MartinPuli/feel/web/README.md

# FEEL website

Static site with no dependencies. `/replay` plays back a session:
- **Left:** the camera recording. This is the iPhone's video for phone recordings, or a rendered view for simulated scenes.
- **Right, stacked:** the 6 × 4 physical pin grid the firmware commanded, above the LiDAR depth frame that drove it. Wire slot 0 is reserved.
- **Below:** a timeline of every column against the labels.

Choose any session, simulated or recorded, from the menu. `?session=<name>` links straight to one. Under the recording, a **top view** plots the LiDAR points from above with the six physical column sectors (simulated sessions also outline the true objects). At each labelled moment, the pin grid shows expected pins and pink-rings any mismatch; the table names the exact physical column, wire slot, expected band, and actual band. Grid-walk trial marks (bump, unsure, arrived) appear on the timeline. **Export video** records a 1920 × 1080 MP4 of the replay for demo videos. See [docs/GRID-WALK.md](../docs/GRID-WALK.md) for live field tests.

```sh
python3 simulation/run.py     # scores every scenario and writes the replay data to simulation/out/web
python3 simulation/unit_tests.py # runs Swift tests and writes their summary for /replay
python3 simulation/pin_diagnostics.py # checks each active pin's app packet and firmware command path
cd web && npm run dev         # http://127.0.0.1:3000/replay
npm test                      # server, six-column replay, report rendering and public-build tests
```

The dev server binds 127.0.0.1 only. It serves `public/` and maps `/replay/data/*` to `simulation/out/web/`, with byte ranges so video can seek. Space plays and pauses; the arrow keys step one 10 Hz tick.

## Phone sessions

In Lantern, turn on **Record depth**. **Include camera video** is a separate explicit choice. The phone writes three files to Files › On My iPhone › FEEL › Recordings:
- `feel-<time>.feelrec`
- `feel-<time>.mp4` (960 × 720 H.264, 15 fps, no audio)
- `feel-<time>.video.json`, which ties video time 0 to the ARKit clock

Trials started in **Grid walk** also write `feel-<time>.events.json`. Copy them all into `simulation/recordings/` and run `simulation/run.py`, or do both with `scripts/pull_recordings.sh` while the phone is connected. New walks appear automatically as `UNLABELLED` sessions; add a scenario in `simulation/scenarios/` to label one.

## Before and after a code change

The page can show two runs of the same recording side by side:

```sh
python3 simulation/run.py --snapshot before    # save this run's pins as "before"
# edit the encoder, column geometry, firmware controller…
python3 simulation/run.py                      # rerun; the run before this one is also kept as "previous"
```

Pick `before` (or `previous`) in the **compare** menu under the scrubber. The pin grid splits into **now** and the snapshot, with changed pins ringed; each timeline row shows now on top and the snapshot below with a mark where they differ; the metrics add how many ticks changed and label agreement snapshot → now. The **◀ diff / diff ▶** buttons (or `[` and `]`) step between differences. `?compare=<label>` links to a comparison. Snapshots live in `simulation/out/web/snapshots/` and are not deployed.

## Deploying

`npm run build` writes `dist/`: the site plus every **simulated** session. **Phone recordings are left out** unless their scenario sets `"publish": true`, because the camera video shows real places and people. The build prints how many it withheld.

The replay data is generated on this machine (Vercel can't run the Swift and C++ replay), so deploy the built folder from here rather than from Git:

```sh
cd web && npm run build && vercel deploy        # preview; add --prod for production
```

`vercel.json` serves `dist/` with no install or build step, with clean URLs and short caching on replay data. Set the Vercel project's root directory to `web`. This deploy path has not been run yet. Check the first preview before promoting it. If the site gets a different home later, `dist/` is plain static files and can be hosted anywhere.

## Branch integration

The six-column display, labelled pin checks and software-report panels come from
`replay-pin-diagnostics` (`6d41c62`). Public builds include only selected report
fields, omit raw build errors and retain the physical-validation limitation.
Reports describe the timestamped run shown; they do not certify the current checkout.

The snapshot comparison from `ethan/cad` (`48774f0`) is not included. It still
uses seven physical columns and can install a stale comparison after a session
change. A future port needs six-column alignment, request cancellation, matching
input identities and tests before it can support reliable comparisons.
