MartinPuli/feel/docs/RELEASE-STATUS.md

## October 18 UTC — current production readiness

**Not ready for unrestricted production.** Latest source, cloud checks and remaining device/configuration gates are recorded in [PRODUCTION-READINESS.md](PRODUCTION-READINESS.md). That report supersedes the historical counts and branch/deployment statements below.

The unsafe 150 ms restoration of old pin bands after a neutral packet has been removed. Only a fresh valid command can raise them again. The latest user-selected GPIO25 calibration is now merged; wiring is unchanged and this firmware has not been flashed. Shared context reads now have a verified-user server boundary, but remain opt-in and inactive until their server deployment is verified. Chalk and existing voice remain usable without that optional connection. See [ESP32 programming](ESP32-PROGRAMMING.md).

## October 18 — Ethan dot tracking synchronized into main

Validation timestamp: 2026-10-18T00:05:12-04:00 (America/New_York). Local main advanced from
`c71fc01` to `8b0789c`; Ethan's `765027e` was already merged by `9fe722a`.
See [integration scope](VERSION-INTEGRATION.md#october-18--ethan-dot-tracking-integration).
This entry supersedes the held-drop behavior described in the historical entry below.

Independent review found and reproduced unsafe stale-band restoration after neutral plus
packet loss. The focused correction keeps neutral latched until a fresh accepted command.
The new regression failed before the fix (43/44), then passed (44/44). Dot animation,
phone-timed taps, six-column mapping, reserved b0 and angle/pulse settings are preserved.

| Gate and command | Result | Evidence / next action |
|---|---|---|
| `sh ios/scripts/test_portable.sh` | PASS: 395 tests | `evidence/ethan-dot-integration-20261018/summary.txt` |
| `sh ios/scripts/build.sh` | PASS: Lantern and Beacon unsigned simulator builds | Xcode 26.6; same summary |
| `sh firmware/test/run_host_tests.sh` | PASS: 44/44 controller tests and all sibling suites | `firmware.log` in the evidence folder |
| `python3 simulation/pin_diagnostics.py` | PASS: 24/24 app-to-controller pin commands | `pin-diagnostics.log`; physical motion unverified |
| `python3 -m unittest discover -s simulation/tests -v` | PASS: 4 tests | `scorer.log` |
| `cd web && npm test` | PASS: 9 tests | `web.log`; rerun outside sandbox to permit local server |
| `python3 simulation/run.py --repeat 2 --no-web` | PASS with existing limitations: 13 PASS, 5 KNOWN, no FAIL; deterministic repeats | `replay.log`; reserved slot invariant passes |
| `python3 simulation/run.py simulation/scenarios/packet-loss-failsafe.json simulation/scenarios/tracking-loss-packet-blackout.json --no-build --no-web --repeat 2 --update-baselines --out /tmp/feel-ethan-neutral-replay` | PASS: both safety scenarios, accuracy 1.0 | `neutral-replay.log`; only these baselines accepted after review |
| `python3 scripts/check_sources.py` | PASS: required source files present | Presence only, not a readiness claim |
| `python3 validation/check_cam_contract.py` | BLOCKED: OpenSCAD unavailable | Install/use existing CAD validation environment, rerun |
| Full iOS UI/device tests; ESP32 build/flash | NOT RUN in this integration | Existing historical results are not new validation |
| Physical hardware | NOT VERIFIED | No flashing, signing, wiring or powered movement performed |

[Evidence folder](evidence/ethan-dot-integration-20261018/summary.txt). The five known replay
limits remain: narrow doorway sector resolution, lintel height, slow detector freshness,
cluttered-hallway filter delay and crossing-person filter delay. The new path wave is covered
by core tests; replay does not model tactile perception, radio transport or servo mechanics.
No new claim of complete product readiness is made.

Next three human actions:
1. Review the integrated moving-dot behavior and the safety-neutral correction before publishing.
2. Validate the dot's left/right direction and target retention on the LiDAR phone.
3. After hardware approval, load the corrected firmware and check all six columns, Stop,
   tracking loss, disconnect and timeout in the supervised bench setup.

## October 17 — firmware held-drop rule (not flashed)

The portable controller now restores a one-packet drop that no packet follows: when an accepted
packet lowers a column from a raised band to 0, the band is remembered and commanded again if no
further packet is accepted within `kHeldDropMs = 150` (beside `kWatchdogMs` in
`firmware/include/feel/controller.hpp`). A later packet always wins, a packet that keeps 0 is a real
disappearance, the restore does not refresh the 500 ms watchdog, and bench `B`/`HL`/`US` are
unchanged. The `packet-loss-failsafe` known issue (a blackout starting on a presence-tap frame held
the pins down until the watchdog) is removed.

| Gate | Observed result |
|---|---|
| Firmware host tests (`sh firmware/test/run_host_tests.sh`) | PASS: 44/44 controller tests (two new) plus every sibling suite; one single-live test now sends a second zero packet to mean a real disappearance. |
| Simulation (`python3 simulation/run.py --no-web`) | PASS: 13 scenarios, 9 PASS, 4 KNOWN, 0 FAIL; `packet-loss-failsafe` PASS at accuracy 1.0, its baseline regenerated (digest changed from t=2.15 s); all other baselines same. |
| Board build (`sh firmware/build.sh`) | NOT RUN: PlatformIO is not installed in this environment. |
| Physical hardware | NOT VERIFIED: nothing flashed; the 150 ms window and the felt crispness of a restore are untested on a servo. |

## October 17 — V2–V4 integration and current-main validation

This entry supersedes older integration and upload-default statements below.
Useful session memory, saved-room restore, local commands, barcode finding,
adaptive highlights and guarded Chalk intents are integrated with main `88c3900`.
See [feature matrix and remaining gaps](VERSION-INTEGRATION.md).

| Gate | Observed result |
|---|---|
| V1/V2 integrated native software | PASS: 268 native unit/integration tests and 12 UI tests; simulator build succeeds. |
| Portable core | PASS: 360 tests. |
| Deterministic six-column simulation | PASS with documented limitations: 13 scenarios ×3; 9 PASS, 4 KNOWN, 0 FAIL. Zero reserved-slot violations. |
| Replay web diagnostics | PASS: nine tests and a local build with 13 synthetic sessions. Browser inspection unavailable. |
| Firmware host contracts | PASS; no firmware, electrical or calibration changes in this integration. |
| V3 software | PASS in software: local grammar, persistence/relocalization gates, barcode and tactile tests. |
| V2/V3 physical hardware | NOT VERIFIED by this work. iPhone reports unavailable; no new install or physical test claimed. |
| Chalk context | PASS: five direct-engine synthetic cases, twelve assertions. MCP parity FAIL; cause unproven. |
| Chalk Python and intent backend | PASS: 135 and 36 tests respectively. |
| Live intent quality/latency | PARTIAL MEASUREMENT; 16/19 measured cloud strict matches, 4/4 local Stop. Cloud p50 1.70 s, p95 2.55 s; 1 s latency target FAIL. |
| Production cloud activation | NOT COMPLETE: optional intent HTTPS deployment, authenticated phone context reads and hosted FEEL eval verification remain. |

Upload consent and public sharing now default off. The app requires a selected
venue and sign-in, never invents a demo venue, and discards stale refresh/retries
after logout, account switch or consent withdrawal. Source tests do not prove a
phone-to-database-to-Chalk-to-phone round trip.

[Chalk validation](evidence/chalk-context/INTEGRATION-VALIDATION.md),
[live text eval](evidence/chalk-context/INTENT-EVALUATION.md), and
[simulation evidence](../simulation/SIX-COLUMN-VALIDATION.md) retain limitations.
The public intent service and the local timestamp fix were not deployed. A team
notebook records FEEL context and feedback; no new support message was sent.

Next human checks: reconnect/unlock the iPhone for installation; verify spoken
commands/mute/headphones; then test real relocalization and tactile responses in
a clear supervised area. These are device gates, not claims of certification.

## October 17 — six-column update

Software checks PASS across current main and isolated V2/V3/V4; ESP32 six-live
upload and six-pin status readback PASS. Current iPhone install BLOCKED because
macOS reports the device unavailable. Physical six-servo integration NOT VERIFIED.
See [evidence](evidence/six-columns-20261017/REPORT.md) and [wiring](SIX-COLUMN-LAYOUT.md).
Earlier seven-column statements below describe historical revisions.

> **Presence taps on `main` (2026-10-17, night):** a raised pin is felt when it moves and fades within seconds when it
> stays (steady pressure rides on slowly adapting afferents whose firing and felt intensity decay exponentially: Chung
> et al. 2015, Bensmaia et al. 2005), so the puck now keeps obstacle pins felt by motion. FeelCore `TapRhythm`, applied
> to the final packet of every 100 ms tick before the adaptive highlight gate: an obstacle pin whose band has not
> changed for 1 s drops to its gap for one packet every 1.0 s, all steady pins together. Target columns keep their own,
> faster taps (the firmware's 13° highlight dip every 600 ms for one column, gated by the tactile profile; the
> encoder's one-in-six drop for a span) and arrows keep their 100 ms frames, so what points at something beats faster
> than what is merely there. Servo budget: a drop is 29° of cam, about 50 ms each way on an FS0307 unloaded (0.10 s per
> 60°) and up to twice that under load; no period may be shorter than three packets. The replayer applies the same
> rhythm; the simulation harness counts a one-tick drop between two identical raised bands as a tap (held longer only
> by lost packets), reports taps per column-second and checks a tap rate per window; `find-door` now also checks the
> wall's presence beat, and `packet-loss-failsafe` records the one cost as a known issue: a BLE blackout that begins
> right after a drop packet leaves the firmware holding that pin down until packets resume or the watchdog fires.
> Software checks on this Mac: FeelCore 370 tests (both targets), Lantern 268 unit tests on the simulator,
> simulation harness: 13 scenarios, 8 pass and 5 known (doorway-open, doorway-with-lintel, find-door-slow-detector, lidar-outliers, packet-loss-failsafe), 0 fail, zero reserved-slot violations, the find-door wall column at 1.0 taps per second, baselines regenerated with the taps; three journey tests that stamp their start at instance creation fail only when the Mac is loaded and passed 12 of 12 when run alone. NOT RUN on hardware: how crisp a 29° drop feels under the cam load and whether 1 s settle and 1 s period suit
> the wearer; both are constants in `TapRhythm` to tune on the device.

> **Phone → Supabase writes on `main` (2026-10-17, night):** the phone now writes the rows Chalk reads. "Found it"
> sends a confirmed find (`confirmed_finds`, the table behind `last_seen`, placed by venue and distance from the room's
> tag); every confirmed target sends an anchor, a visit's map goes when sensing stops, and each kept journey goes when
> the walk ends (`anchors`, `room_maps`, `journeys`, marked shared unless the user default `feel.shareRoomMemory` is
> false). One PostgREST insert each, with the publishable key and the signed-in user's token (`SupabaseWriter`, behind
> `RoomMemory.uploader` and `JourneyLog.uploader`; `user_id` is the token's subject, as Row Level Security requires).
> A token about to expire, or refused with 401, is exchanged once for a new one with the saved refresh token, which
> replaces the sign-in's; rows outside a table's limits are dropped on the phone; `get_status.room_memory.uploads`
> reports sent, failed and skipped with the last reason, the user id and the venue. Rows are filed under the loaded
> venue pack's venue, else `rubenstein-treehouse`. Software checks on this Mac: Lantern 205 unit tests on the
> simulator, the wire shape against a stub server. NOT RUN on a device: no phone was reachable, so no row written by
> a phone has been seen in Supabase or through Chalk yet. Still pending: the download of shared memory
> (`RoomMemory.fetchSharedStructure`) and a `last_seen` tool on the phone.

> **Journey loop, Chalk side, on `claude/journey-chalk` (2026-10-17, night):** every walk from a printed tag toward a
> remembered target is a journey (`journeys` table with its opt-in `shared` flag, `Journey` feature,
> `feel_chalk/journeys.py`); the shared journeys of the last 60 days join the merged structure in
> `RoomMemory.world_map` (recomputed daily by the scheduled query `world_map`); `Path` plans a suggested direction over
> that map from a pose to a remembered label (A* on half-metre cells, `feel_chalk/path.py`) and serves the polyline and
> progress points every 6 m through the named queries `path` and `progress_points` (`context.py path`);
> `feel_chalk/journey_eval.py` scores frozen holdout journeys (arrived, min clearance, path efficiency, cue latency p95),
> ranks collisions first, then efficiency, then latency, and promotes a candidate only when better in that order.
> `protocol/journey-v1.json` is the vector both sides reproduce; `sql/upgrade-journeys.sql` is the delta for existing
> databases. Software checks on this Mac: chalk 133 tests (10 skip without chalkpy, pass with it), `feel_context`
> import-checked with chalkpy 2.163.1, `schema.sql`, `seed.sql`, `access.sql` and `upgrade-journeys.sql` run on a local
> Postgres 17 with a stub `auth.uid()`. Pending: the phone's write of journeys and read of progress points, the device
> test of the loop, the Chalk deployment (the scheduled query has never run), and the SQL against the live Postgres.
> Nothing here is deployed yet. A path is a suggested direction, never a claim that the way is clear.
> **Journey loop, phone side (2026-10-17, night):** every walk toward a chosen target is a `Journey` (FeelCore
> `Journey.swift`: pose steps every 0.5 m or 2 s with a heading, the blocked floor cells seen on the trip, cue
> latencies, arrival time and distance) recorded in the printed tag's levelled frame and kept as JSON under
> `Application Support/Journeys` (`JourneyLog`, beside room memory); `JourneyLog.export` writes them all to
> `Documents/journeys.json` for the Files app, and `JourneyLog.share` is the empty Supabase write. A route to a held
> or remembered target is split once into progress points every 6 m (`ProgressPoints`, last point the target) and the
> pins point to the next one (`WaypointFollower`, advance within 1 m, "Next point." once per point, "You're there"
> at the end); a target without a route keeps the straight bearing, and the pins show live depth throughout. New
> assistant tool `lead_me(label)` for a remembered place; `get_status.room_memory.journey` reports steps, obstacles
> and the next point. `protocol/journey-v1.json` is the vector shared with Chalk. Software checks on this Mac:
> FeelCore 276 tests, Lantern 186 unit tests on the iPhone Air simulator. NOT RUN on a device: the recorded walk of
> a real room, the planner's route split and the pins following its points, the spoken "Next point." through the
> assistant, and the export from the Files app. No upload yet.

> **Room structure memory on `feel/room-structure` (2026-10-17, night):** with the printed tag in view, the floor grid a
> session learned is exported into the tag's levelled frame when sensing stops or tracking resets (FeelCore `RoomMap`:
> 10 cm cells, run-length encoded) and kept per tag as one visit (the newest ten, `RoomMemoryStore`); the first sighting
> of the tag in a later world seeds the route planner with the per-cell merge of those visits, so the arrows can head for
> a remembered exit before the camera has seen the room. Live classifications override the prior cell by cell; the pins
> never read it; `get_status` reports `room_structure` (visits, cells, blocked, seeded). Chalk merges shared visits by the
> same vote (`room_maps` table with its opt-in `shared` flag, `RoomMap` → `RoomMemory.structure`, named query
> `room_structure`, `context.py room-structure`, `sql/upgrade-room-maps.sql` for existing databases);
> `protocol/room-map-v1.json` is the vector both sides reproduce. Software checks on this Mac: chalk 98 tests (7 skip
> without chalkpy, pass with it), FeelCore 259, Lantern 174 unit tests on the iPhone Air simulator. NOT RUN on a device:
> the tag recognition this depends on (still pending from room memory), the exported map of a real room, and the arrows
> following a remembered wall. Still pending: the phone's upload of visits (`RoomMemory.shareStructure`) and download of
> Chalk's merged map (`RoomMemory.fetchSharedStructure`), both empty functions, the Chalk deployment, and the SQL against
> a live Postgres.

> **Room memory on `feel/chalk-track` (2026-10-17, night):** a printed FEEL tag (`ios/Lantern/Resources/feel-tag-01.png`,
> printed 20 cm wide) recognized by ARKit image detection gives the room a frame; targets confirmed with "found it" or by
> arriving at a Where-is target are stored in that frame on the phone (`RoomMemoryStore`) and, when the user shares them,
> aggregated by Chalk (`Anchor` → `RoomMemory`, named query `room_anchors`, the `anchors` table with an opt-in `shared`
> flag). A later "where is the exit" with the tag seen points the pins at once and answers "Last time the exit was about
> 2 meters ahead to your left. Pins point there. Say photo to check again."; `get_status` reports `room_memory` hits and
> misses. Software checks on this Mac: chalk 78 tests (5 skip without chalkpy, pass with it), FeelCore 224, Lantern 154
> unit tests on the simulator. NOT RUN on a device: ARKit's recognition of the printed tag and the frame it returns, the
> accuracy of a remembered position after relocalization, and the spoken cue behaviour. Still pending: the Chalk
> deployment, the SQL against a live Postgres, and the phone's write of anchors to Supabase.

> **`feel/chalk-track` (2026-10-17 evening):** Chalk context features (`chalk/feel_context`: Find, ObjectHistory, VenueEntry,
> Venue with named queries `last_seen` and `venue_pack`), Postgres schema and seed, a standard-library query client, a `--local`
> evaluation mode with a synthetic dataset (12-row run recorded in `docs/evidence/chalk-synthetic/`), the open-side finder
> (FeelCore `OpenSide`: "more room to your left" in obstacle notices, `open_side` in status, one sweep cue under the arrows toggle)
> and five SVG figures. Software checks on this Mac: FeelCore 208 tests, Lantern 143 unit tests, chalk 65 tests (3 skip without
> chalkpy, which pass in a venv that has it). Not done: the Chalk deployment (needs the Postgres data source and the CLI), the
> phone write path for finds, and any device test of the open-side cue.

> **Chalk production setup (2026-10-17):** metadata-only trace policy saved; two synthetic image requests passed. Quota enforcement is disabled in the managed backend and has been escalated to Chalk with user authorization. Public production remains blocked. See [current gates](CHALK-PRODUCTION.md).

> **Current Chalk environment follow-up (2026-10-17):** Feel production routing and two generic text requests passed. CLI login is configured; no dataset or hosted evaluation run exists yet. Earlier image/simulator results below are historical and do not validate the new key on the phone. See [current implementation and remaining checks](CHALK-IMPLEMENTATION.md).

> **V4 on `feel/v4-chalk` (2026-10-17 03:40): Where-is through Chalk's Model Gateway with an on-device
> fallback (Vision reads EXIT signs, door shapes and people; the bundled Core ML detector finds chairs
> and common objects), typed requests, sessions that survive missing sound output, a review fix pass,
> and a minimalist-neobrutalist restyle, on top of main's OpenAI voice stack. Software checks PASS on
> this Mac and in the iOS Simulator. Physical camera, LiDAR, puck and live speech: NOT RUN here.**
> Details at the end of this file.

> **Merged Ethan's branch (2026-10-17 ~11:45): direction arrows, point-to-describe, target spans,
> depth recording, synthetic scenes and the replay harness now live on `main` next to Where-is,
> on main's OpenAI voice stack.** Ported: the keyword listener borrows the OpenAI session's
> microphone; the "which one?" question is an in-conversation `response.create` (OpenAI has no
> `force_message`). A placed Where-is target becomes the arrows' route goal, so "where is the exit"
> gets the tactile arrow along the planned route and the pin, with no failure tone while the planner
> has no route yet. After the merge: FeelCore + FeelSim 184 tests, Lantern 112 unit tests (1 skipped
> in the simulator) and the UI suite pass locally. Ethan's own caveats below still hold: nothing of
> his has run on a hand, a LiDAR map, a route or a physical column.

> Steady pins, path wave and a floor that follows the wearer (October 17, field report
> after a stair descent): (1) a sector now reports its third-nearest confident LiDAR
> point and `SectorFilter` steadies bands between frames (nearer after two agreeing
> frames, under 0.9 m at once; farther or unknown after four frames and 10 cm past the
> boundary), so walking bob and stray pixels no longer flutter the pins; (2) `PathWave`
> runs a dot from the centre column toward the route while the wearer turns, with no
> sign, never covering a raised pin, so a one-column doorway is found by turning, and a
> detected target that turns out of view keeps its route for 8 s; (3) calibration now
> latches the camera's height above the floor and recomputes the floor level from the
> worn camera every frame, so a wall at the bottom of a staircase is back inside the
> 0.6–2.1 m window; the floor map restarts when the level moves over 0.4 m. Local
> results: 247 FeelCore tests (19 new) and 8 FeelSim tests pass; Lantern builds for the
> iPhone 17 Pro simulator; all 12 replay scenes pass or stay KNOWN (the LiDAR-outlier
> scene is now a plain PASS with zero flicker; the lintel and slow-detector issues
> remain). Replay baselines were re-accepted for the steadying delay. Not yet tried on
> the phone: how the wave feels, the stair walk, and the turn-rate threshold.

> Replay harness (October 17): `python3 simulation/run.py` replays labelled depth
> recordings (12 synthetic scenes now; iPhone recordings via the new Lantern
> **Record depth** toggle) through the shared FeelCore depth step, the production
> encoder and the production C++ controller, and scores the commanded pin grid over
> time. 9 scenes pass and 3 KNOWN issues are reported: a 2.03 m door head reads as
> an obstacle, the tap drops out with ≥ 0.15 s detector latency, and single LiDAR
> outliers raise pins. 8 FeelSim and 148 FeelCore tests pass; Lantern builds and its
> 40 unit tests pass (1 skipped). No phone recording has been captured or replayed yet.
> [Harness](../simulation/README.md). The new FEEL site (`web/`, local only so far) adds
> `/replay`: choose a simulated or phone session and watch the camera recording beside the
> commanded pin grid and LiDAR depth. Phone camera video is recorded but untested on a device.

> Direction arrows (October 17, supersedes the repeating guidance wave): a V hand sign
> requests one tactile arrow along an A* route over a local LiDAR floor map to the
> target in view. Later arrows play only on noticeable route changes or a repeated
> sign. No firmware or protocol change. Local results: 118 FeelCore tests, 34
> Lantern unit tests (1 pointing detector test skipped in the simulator), 8 UI tests
> and the 11-scenario pointing harness passed. Both apps build. Not installed on the
> phone. No real hand, LiDAR map, route or physical column tested.
> Update: the V sign plus one spoken word ("exit") picks the target, using on-device
> recognition. Guidance uses sounds only (success chime, failure tone, listening blip).
> Several targets in view make the assistant ask which one (`choose_target`).
> Now 135 FeelCore, 40 Lantern unit and 8 UI tests pass. Speech recognition, the
> microphone hand-off and the assistant question are not tested on a device.

> Seven-servo preparation: `esp32-production` and its English setup guide are
> ready in source. Host/configuration tests, enabled-output compile fixtures and
> 2,634 cross-layer assertions passed. Real deployment is still gated on the
> seven units' missing physical measurement records. No board was flashed; the
> user has only one servo connected. [Evidence](evidence/seven-production/report.json)
> and [setup](SEVEN-SERVO-PRODUCTION.md). This is not full-device physical acceptance.

> Latest installed profile: `esp32-single-live`, source64fae62, uses nominal120°
> production center-sector mapping on GPIO32. Compilation, host regressions,
> upload and idle readback passed; physical full-range motion remains unverified.
> [Installation evidence](SINGLE-SERVO-LIVE.md#installed-validation). Earlier
> references below to the installed midpoint demo describe the prior state.

# Current V1 release candidate

## Current proactive voice update — October 17

Build 14 is signed, installed and launched on the paired iPhone at 01:48 EDT.
OpenAI accepted the expanded voice tool set; phone diagnostics show readiness
and successful audio-engine recovery. Spoken action checks with the user and
headset behavior remain pending. The production token service retains provider
credentials on Vercel. The FEEL wordmark has a matching control background.

V1 adds event-driven nearby-obstacle and target-movement notices, sensing
recovery, and spoken access to the app's operational controls. “Silence yourself”
mutes speech while preserving microphone capture and commands; “speak again”
unmutes. “Stop listening” ends capture and requires touch to resume. iOS permission
choices and credential entry remain manual. The phone still pauses capture when
backgrounded or locked. [Evidence](evidence/v1-proactive-voice/validation.txt).

All 60 native unit/integration tests and 7 UI tests passed.
Independent review identified a sub-0.3 m filtering issue, fixed with regression
coverage. Earlier [OpenAI migration evidence](evidence/v1-openai-voice/validation.txt)
records the prior 40 native tests, 7 UI tests and 18 service tests.

## Prior iPhone voice provisioning

Build 8 used Grok/Sal. The user confirmed live voice input and spoken responses,
then reported disconnections. Its historical activation evidence is preserved
in [the provisioning record](evidence/v1-voice-provisioning/validation.txt).
Build 6 introduced foreground listening and accessible Assistant controls.
Backgrounding or locking pauses microphone capture; camera images remain local.

## Current iPhone visual update

Lantern now uses a chevron drawer in the [camera-first interface](V1-CAMERA-UI.md).
Tapping or dragging the arrow reveals the 7×4 packet display, status and rounded
Start camera action. Connection and Settings float over the camera. Stop remains
available with the drawer closed and inside either modal. Five integration tests
and six UI tests passed locally; Lantern builds and signs as 1.0.0 (5).
[Current screenshots and checks](evidence/v1-drawer/validation.txt).

Lantern 1.0.0 (5) was installed and launched on the paired iPhone 17 Pro on
October 17. Device app inventory confirms build 5. This confirms installation
and launch, not physical sensing/actuation performance. Beacon's interface is
unchanged; it was not rebuilt or installed during this update.

## V1 consolidation on main

The user designated `main` as V1 on October 16, 2026. The integration preserves
the existing `main` planning document, incorporates foundation `2df1c07`, and
includes app design commit `da12787`. V2 and V3 remain separate.
The app redesign passed local simulator builds and 46 distinct tests (38 shared
core, 3 Lantern integration, 3 Lantern UI, 2 Beacon UI). See
[app design evidence](evidence/v1-design/validation.txt). The integration is
published with `[skip ci]` because of the existing Actions billing blocker;
no hosted validation result is claimed for this merge.

Post-merge local checks passed: source presence, 7 tooling tests, 51 reference
model tests, production firmware host/adapter/demo/bench checks, and 2,634
cross-layer assertions across 558 firmware states. No board was flashed during
the consolidation. [Integration log](evidence/v1-main-integration.log).

The design uses nominal FS0307 **120°** travel, not a measured endpoint.
Default ESP32/ESP32-S3 firmware keeps seven-servo output disabled until measured
pulse limits are supplied. The separately selected `esp32-single-demo` uses only
GPIO32 and the center camera sector, within nominal1450–1550 µs. It is the version
last installed on the user's board; it does not operate the seven-column cam.

A signed iPhone installation and BLE packet receipt were verified locally. The
user reported successful five-second bench motion and then small live app-driven
servo motion. Boot readback confirmed the demo timer ready and output detached.
See [single-servo evidence](SINGLE-SERVO-IPHONE-VALIDATION.md) and
[bench evidence](../firmware/bench-single/VALIDATION.md). These observations do not
measure pulse width, angle, power under load, sensing accuracy or stop latency.

Release hardening adds explicit50 Hz APB timer configuration,14-bit duty
quantization within supplied pulse limits, malformed serial-line rejection, and
CI coverage for both single-servo builds. Physical validation of full120° travel,
seven actuators, printed mechanics and tactile use remains **NOT VERIFIED**.
Current local software checks **PASS** on source `5f3ded9`: five primary firmware
variants plus the standalone bench build; complete host regressions;38 Swift core
tests;2,634 cross-layer assertions;104 actual-CAD/controller contract checks;
24 mesh exports;80 cam checks; model integrity; Xcode26.6 simulator tests
(3 app tests and1 UI test), companion simulator build and both unsigned device
builds. [Commands and evidence](evidence/v1-release/report.json) identify each
check. Published to `feel/v1-foundation` at `57c7e6b`. Hosted CI is **BLOCKED**:
GitHub refused to start every job because of account billing/spending limits.
[GitHub evidence](evidence/v1-release/github-actions.json) records the exact
annotation and run URLs. Resolve account billing and rerun; no hosted test ran. The hardened firmware
has not been flashed; the board retains the prior tested single-demo build. No claim of production hardware readiness is made.

## Historical foundation evidence (before the 120° revision)

# FEEL V1 release status

**Software validation: PASS, including hosted Apple-platform checks.
Physical hardware: NOT VERIFIED.** October 16, 2026.

This is a greenfield implementation from the specification. It does not recover
or inherit test results from an original implementation. The complete runner
executed 14 available checks successfully and returned exit 2 because this Linux
host has no Xcode/XcodeGen/iOS simulator. Hosted macOS CI then completed all four
jobs successfully for source commit `f6244379e7e8e9dad81f84fb4cd8886f9e77c7ee`.
Xcode 16.4 passed three app unit tests, one UI test, both simulator builds and
both unsigned iPhone builds. CoreML inference and signed installation remain
device work. [CI run](https://github.com/MartinPuli/hackharvard/actions/runs/38972250150)
and [recorded results](evidence/v1/github-actions.json) identify the tested snapshot.
The user explicitly authorized publication after the earlier automatic-review block.

| Area | Result | Evidence / remaining gate |
|---|---|---|
| Production Swift core and CLI | PASS | 38 XCTest cases; compiled replay executable |
| Production firmware controller | PASS | 38 C++ cases; 17 CLI, 6 configuration and 6 upload-guard checks |
| ESP32 and ESP32-S3 | PASS compilation | Default and enabled-output compile fixtures, four builds; no flashing |
| Swift → nine-byte packet → C++ replay | PASS | 1,518 assertions, 558 firmware states, seed 20261016 |
| OpenSCAD and meshes | PASS geometry | 24 exports with manifest hashes, 78 cam assertions, 13 tool regressions |
| Apple CoreML resource | PASS integrity | Genuine pinned model downloaded and SHA-256 verified; inference NOT RUN |
| Offline replay and actual-mesh viewers | PASS | Chromium interaction/rendering, desktop/mobile; synthetic geometry/data |
| Tooling / historical Python model | PASS | 7 tooling and 51 reference-model tests; model is separate from production |
| iOS platform | PASS | Hosted Xcode 16.4: 3 app + 1 UI tests; Lantern/Beacon simulator and unsigned device builds |
| Servos, printed parts, power, BLE radio, LiDAR, NI, tactile use | NOT VERIFIED | Physical P1–P5 and device bring-up remain required |

Command: `python3 scripts/run_v1_checks.py --output .artifacts/v1-validated`.
Exact commands/logs and host limitations: [evidence/v1/report.json](evidence/v1/report.json),
[TEST-REPORT.md](TEST-REPORT.md), [REVIEW.md](REVIEW.md).

The user's criterion is all **available** software checks. That foundation gate
has passed, including the subsequently available hosted Mac checks; V2 Spatial
Memory may proceed in its own branch. V1 remains preserved here. This milestone
does not establish real sensor, radio, electrical or tactile behavior.

Primary hardware is the team's classic ESP32-WROOM. Servo PWM defaults OFF.
Published FS0307 travel/voltage differs from the handoff's 175°/650–2500 µs
assumption. Identify and measure the actual units before enabling output. Nominal
CAD clearances, horn fit, thin-guide stiffness and foam return are unverified.

## V4: Where-is through Chalk with an on-device fallback, typed requests, no-audio resilience (2026-10-17)

| Check | Result | How |
|---|---|---|
| Swift core (portable) | PASS, 65 tests incl. held target, depth grid, placement, on-device vocabulary, held-target guidance | `sh ios/scripts/test_portable.sh` |
| App unit tests (simulator) | PASS, 104 tests: gateway, Where-is service with the on-device fallback, `where_is` command, the review fix pass, existing suites | `xcodebuild … -only-testing:LanternTests` |
| On-device fallback (simulator) | PASS: `ObjectDetectorTests` reads a rendered EXIT sign through the same Vision path the phone uses; the Core ML classes need `python3 scripts/fetch_model.py` before the device build | `xcodebuild … -only-testing:LanternTests/ObjectDetectorTests` |
| UI tests | PASS, 8 tests: existing suite with the restyle and the Where-is setup (the voice-setup test now scrolls without momentum) | `bash scripts/check_ios.sh` |
| Chalk gateway from this Mac | PASS: text and image requests on `openai/gpt-6.1-sol`, 2.6–3.7 s | `chalk/check_connection.py --chat` |
| Chalk gateway from the app | PASS in the iOS Simulator: the sample photo went through the real request, parser and placement code; "Found '3D puck model' … in 4.2 s" | Assistant panel → Where-is setup → Test with a sample photo |
| Chalk Evaluation run | BLOCKED: needs `chalk login` and venue photos | `chalk/README.md` → Run the evaluation |
| OpenAI Realtime voice | PASS in the iOS Simulator for connect, session setup, readiness line, a typed request, the app tool call and the spoken reply as a caption. Sound output is unavailable in the simulator (no running audio engine); the session now continues without it. Audible speech and the microphone: check on the phone | Assistant panel, typed request "where is the exit" |
| Where-is on the LiDAR iPhone | NOT RUN: checklist below | — |

### Camera and LiDAR conventions, checked against Apple's documentation

- `ARCamera.transform`: in camera space the x-axis points right when the device is in
  `UIDeviceOrientation.landscapeLeft`, y points up, z points toward the screen side. The
  app's landscape-left mount therefore gives +x right, +y up and −z forward, which is what
  `CameraIntrinsics.unproject` and `TactileGeometry.bearing` assume.
- `ARCamera.intrinsics`: fx, fy and the principal point are in pixels from the top-left of
  the captured image; the app scales them to the 256×192 depth grid by the ratio of depth
  size to `imageResolution` (`ARPerception.intrinsics`).
- `ARDepthData.depthMap`: metres, `kCVPixelFormatType_DepthFloat32`; `confidenceMap` holds
  `ARConfidenceLevel` low/medium/high (0/1/2) and only medium and high are used.
- `ARFrame.capturedImage`: full-range YCbCr; `CIImage` converts it for the Where-is JPEG. It
  shares the depth map's orientation, so the model's box maps to depth pixels unrotated.

### On-device fallback

"Where is X?" asks Chalk first. Without Chalk settings, or when the gateway fails or does not
answer within 12 s, the same photo goes to the phone's own detector (`LocalWhereIs` →
`ObjectDetector`): Vision text recognition for EXIT signs, Vision rectangles for door candidates,
Core ML or Vision human rectangles for people, and the bundled Core ML detector
(`FEELDetector.mlmodelc`, Apple's pinned YOLOv3, 80 COCO classes) for chairs and common objects.
The user's words are matched against a fixed vocabulary (`LocalVocabulary`: articles dropped,
plurals tried, last word as a fallback, so "registration desk" finds a table). Anything else
offline gets "I can only look for the exit, a door, a person, a chair or common objects right
now." The target is named by the user's own words, never by a model label. The sample-photo
self-test stays Chalk-only so its result reflects the gateway setup.

### Review fix pass (fresh-context review of the whole branch)

Fixed, each with a test that failed first: a new ask clears the previous target, cancels the
lookup in flight and resets the finder; a photo from an earlier ask is dropped; a placement from
a world that has since reset is refused ("Lost tracking. Say it again."); a target placed outside
the pins' field says its direction at once and "I no longer see your target" is never spoken for
a held target; finder and teammate targets never shadow a held target; a result line the
assistant could not speak (mid-reply, or inside the five-second announce throttle) is retried
from the tick for ten seconds; a typed request is refused while a reply is running instead of
racing it; the "audio engine not running" tolerance is confined to simulator builds; arrival
("You're at the …") counts only while sensing is live.

### Device checklist for the hardware session (not yet run)

1. Run `python3 scripts/fetch_model.py` (pinned, SHA-256 checked) so the bundle includes the Core ML
   detector, then install from `feel/v4-chalk-ben` (or `main` after the merge). In Assistant
   settings enter the voice service; the Where-is gateway settings are optional (or launch with the
   DEBUG provisioning variables). Without them Where-is runs on-device only.
2. Start the camera, calibrate with the measured lens height, confirm `Where-is ready` (Chalk) or
   `Where-is not set up` (on-device only).
3. Say "where is the chair": confirmation within 1 s, spoken observation and pin within 6 s;
   turn 90°, the pin follows; walk to it: "You're at the chair."
4. Say "where is the refrigerator" with none present: "I couldn't see a refrigerator in the photo."; no pin change.
5. Hold a target, cover the camera until tracking resets: "Lost tracking. Say it again."; pins neutral.
6. Hold a target, turn your back to it: "chair is behind you." within 5 s; "stop": highlight off, obstacles still shown.
7. Airplane mode with Chalk configured, near an EXIT sign: "where is the exit" → pin within about
   13 s (12 s gateway timeout, then on-device); "where is the unicorn" → the vocabulary line.
8. Record PASS/FAIL per step here with the commit.
