MartinPuli/feel/docs/SINGLE-SERVO-LIVE.md

> Current six-column revision: GPIO32 is unused. Use [SIX-COLUMN-LAYOUT.md](SIX-COLUMN-LAYOUT.md)
> for current wiring and the `esp32-six-live` target. Historical single-servo
> examples below using GPIO32 are superseded; current single profiles use GPIO33.

# Single-servo live V1: nominal120° mapping

The user requested the production mapping instead of the small midpoint demo.
The opt-in `esp32-single-live` environment applies the existing production
controller's center-sector pulse to GPIO32 only. It uses nominal900–2100 µs for
0/40/80/120° band selection, including the controller's gap transitions and
highlight behavior. These are design values, not measured travel or waveform.
It does not enable the other six servo outputs or verify the complete device.

The previous `esp32-single-demo` environment retains its1450–1550 µs range.
Default seven-servo builds still require separately supplied measured limits.
The live environment is a user-selected nominal profile, not measured calibration.

Boot, no connection, stale packets, all-zero Stop and disconnect detach output.
A central band of0 while other sectors are occupied follows the controller's
neutral gap. Serial bench/raw/calibration commands remain unavailable in this
profile. The production500 ms watchdog and packet checks remain active.
Detachment does not disconnect servo power or prove passive pin return.

## Use

After uploading, reconnect the iPhone to **FEEL Center Live** (a cached old
name may persist), start **Live sensing**, set
**Camera height**, then **Calibrate floor**. Move a large object between distance
bands in the center camera sector. Expect distinct positions instead of the
small demo motion. Use **Stop** to end live commands. Avoid holding the shaft;
remove servo power if it jams, heats or buzzes continuously.

A software build and firmware readback establish installation only. Observe
travel and stop behavior before mounting a cam. Full120° sweep, load/voltage,
mechanical fit and seven-column operation remain separate physical gates.

## Installed validation

Source: `64fae62`. Host suite,21 configuration checks and all three classic
profiles (default, midpoint demo and live120) compiled/passed. Independent review
found no blocking defects. Upload to the connected classic ESP32 succeeded with
uploader hash verification. Serial readback showed `LIVE120`, `ready=1`,
`attached=0`, `pulseUs=0`, `timerHz=50`. No motion command was issued during the
readback. Serial was closed afterward. The user must reconnect the iPhone.
No stored120° calibration record was present; offsets therefore use defaults.
Servo supply disconnection was not newly confirmed; powered reset transients
were not measured. Full-range physical motion after this update is NOT VERIFIED.

Evidence: [host](evidence/single-live/host.log),
[build](evidence/single-live/build-excerpt.log),
[upload](evidence/single-live/upload-excerpt.log),
[boot/status](evidence/single-live/status.log).

Firmware SHA256: `71fe47155950bc2ab29e76f4f289ec49897c31caf7c7fda841843d4158c75d50`.
