MartinPuli/feel/docs/MAIN-SYNC-2026-10-17.md

# Main and version synchronization — October 17, 2026

Main remains V1. Integrated upstream `f2fb703`, including Where-is, direction
cues, pointing, recording, synthetic replay and production CAD references.
V2/V3/V4 retain their isolated features and inherit this main snapshot.

## Shared corrections

- Cached pointing pins require live sensing; invalid tracking/depth stays neutral.
- Global mute blocks new pointing speech and stops its active synthesizer.
- Simulator pointing uses the verified Vision CPU revision. Physical devices keep
  their default Vision configuration. All 15 synthetic detector cases pass.

PASS: 113 native main tests, zero failures, and unsigned iPhone compilation.
Independent review found no critical/high issue in this three-file change.
Evidence: `/tmp/feel-main-safety-tests.log`, `/tmp/feel-main-safety-device.log`.

Commands used after `xcodegen generate --spec ios/project.yml`:

```sh
xcodebuild -project ios/Lantern.xcodeproj -scheme Lantern -configuration Debug \
  -destination 'platform=iOS Simulator,id=2CEF5AB6-CC8C-4F3F-898F-AB4A7335DFFD' \
  -derivedDataPath /tmp/feel-drawer-sim -parallel-testing-enabled NO \
  -collect-test-diagnostics never -only-testing:LanternTests \
  CODE_SIGNING_ALLOWED=NO test
xcodebuild -project ios/Lantern.xcodeproj -scheme Lantern -configuration Debug \
  -destination 'generic/platform=iOS' -derivedDataPath /tmp/feel-camera-install \
  CODE_SIGNING_ALLOWED=NO build
```

## Version integration evidence

| Version | Software checks | Simulation / physical limits |
| --- | --- | --- |
| V2 | 204 core; 117 native (one Vision skip before the shared simulator fix); 10 UI; device build PASS | Replay twice: nine PASS, three known limitations; hardware NOT VERIFIED |
| V3 | 236 core; 135 native across full run and detector retry; three selected UI; device build PASS | Hardware NOT VERIFIED |
| V4 | 236 core; 159 native; three selected UI across retries; device build PASS; 28 service and four report tests PASS | 67-file hardware boundary unchanged from V3; hardware NOT VERIFIED |

Detailed commands and retries are recorded in `docs/VERSION-VOICE-SYNC.md` on
each version branch. UI retries corrected scroll targeting, without dropping
consent, Stop or functional assertions. Main's shared corrections are propagated
after these validated integrations. No firmware, credentials or physical geometry
were changed by these corrections. No new phone installation was performed.

Known replay limitations remain door lintel interpretation, slow detection and
LiDAR outliers. Matching simulation baselines do not establish safe navigation.

Next human checks: install the chosen V1 build; verify mute/reconnect/headphone
behavior; validate sensing and tactile output in a supervised clear indoor area.
