MartinPuli/feel/docs/ELIGIBILITY.md

# Provenance and organizer questions

- Original GitHub repository had no production source. Earlier work in
  `feel/v2-preparation` supplied reference simulation, tests and documents only.
- HANDOFF-v7 describes a pre-existing design and claimed implementation elsewhere;
  those files were never provided. This branch is a **greenfield recreation**, not
  an imported/reproduced original. Historical verification claims are not inherited.
- New source includes Swift, firmware, CAD and cross-layer tests. Git history records
  the work; do not claim the underlying idea/design originated this weekend.
- Third-party model weights remain third-party, with pinned source/hash and license
  attribution. No user images or sensor recordings are bundled.

Ask an organizer whether pre-event design/reference material and preparation tools
are eligible, what must be disclosed, and how AI coding assistance should be
reported. Record the actual answer, date and organizer here: **UNRESOLVED**.

Confirm team≤4, exact Devpost requirements, track selection and repository
visibility. The supplied event document says submission is Sunday October 18 at
8AM ET; confirm any organizer changes. No eligibility approval is assumed.
