MartinPuli/feel/simulation/report.html

# FEEL replay report

SIMULATION · Six physical columns; wire slot b0 reserved. Production Swift encoder + production C++ controller. No servo physics, feel, BLE radio or live detector.
