MartinPuli/feel/cad/production/markers/puck-back.pdf

# FEEL puck back sheet: print at 100% (Actual size); the bar must measure 50 mm

50 mm

Cut on the dashed line. Codes go at the WRIST end (cable slot); the rounded corners go at the FINGER end.
Printed side out. Matches the production chassis in CAD.md only. Two spares.

C0 B1

C0 B2

C0 B3

C0 B4

C1 B1

C1 B2

C1 B3

C1 B4

C2 B1

C2 B2

C2 B3

C2 B4

C3 B1

C3 B2

C3 B3

C3 B4

C4 B1

C4 B2

C4 B3

C4 B4

C5 B1

C5 B2

C5 B3

C5 B4

C6 B1

C6 B2

C6 B3

C6 B4

C0 B1

C0 B2

C0 B3

C0 B4

C1 B1

C1 B2

C1 B3

C1 B4

C2 B1

C2 B2

C2 B3

C2 B4

C3 B1

C3 B2

C3 B3

C3 B4

C4 B1

C4 B2

C4 B3

C4 B4

C5 B1

C5 B2

C5 B3

C5 B4

C6 B1

C6 B2

C6 B3

C6 B4

C0 B1

C0 B2

C0 B3

C0 B4

C1 B1

C1 B2

C1 B3

C1 B4

C2 B1

C2 B2

C2 B3

C2 B4

C3 B1

C3 B2

C3 B3

C3 B4

C4 B1

C4 B2

C4 B3

C4 B4

C5 B1

C5 B2

C5 B3

C5 B4

C6 B1

C6 B2

C6 B3

C6 B4

C0 B1

C0 B2

C0 B3

C0 B4

C1 B1

C1 B2

C1 B3

C1 B4

C2 B1

C2 B2

C2 B3

C2 B4

C3 B1

C3 B2

C3 B3

C3 B4

C4 B1

C4 B2

C4 B3

C4 B4

C5 B1

C5 B2

C5 B3

C5 B4

C6 B1

C6 B2

C6 B3

C6 B4
