MartinPuli/feel/docs/REVIEW-PREPARATION-HISTORICAL.md

# Independent engineering review

Reviewed October 16, 2026 by a separate engineering agent with read-only ownership. The author agents and lead engineer integrated fixes; the reviewer did not edit its own reviewed files. Review scope was the new preparation tools, reference model, fixture evidence, CI and hardware/submission documentation. The missing production implementation could not be reviewed.

| Finding | Severity | Resolution / evidence |
|---|---|---|
| Empty scenario suite, empty event list, empty and nested-empty expectations falsely returned PASS; renderer could receive no step | Medium | `validation/run_scenarios.py` now rejects these inputs. Regression tests and independent direct reproductions confirm rejection. |
| Gap-transition replay asserted bands but not actual nominal phase/angle, so an incorrect command implementation still passed | Medium | `nominal_gap_transition` asserts column commands at gap/band/hold/timeout boundaries. Independent injection of neutral/999° output now fails five replay steps. |
| Command timeout killed only the direct process; compiler/build descendants could continue and race artifact writes | Medium | Runner owns a Linux/macOS process session and kills its process group on timeout. Real child-process regression confirms the delayed child write does not occur. |
| Direct iOS helper invocation failed at `cd` before classifying missing sources | Low | Missing `ios/` now produces explicit BLOCKED and exit 2. Verified directly. |

Reviewer independently reran **51 model tests**, **6 preflight/runner tests** and **18 scenarios / 77 steps**, all passing within the stated model scope. No unresolved high/critical defect was found in the reviewed preparation tooling. This is not a guarantee of completeness or a production V2 sign-off.

The hardware and Devpost documents were checked for unsafe unverified electrical commands, concealed pre-event work and fabricated physical results. They require the missing original assembly source and measured parts; they do not prescribe blindly running the handoff's full pulse sweep. Browser rendering was not verified by this review.

Remaining blockers: original CAD/firmware/iOS and production contract adapter, real toolchain builds, all physical/sensor verification, and organizer clarification. See `KNOWN-ISSUES.md`.
