MartinPuli/feel/cad/evidence/geometry-preview.png

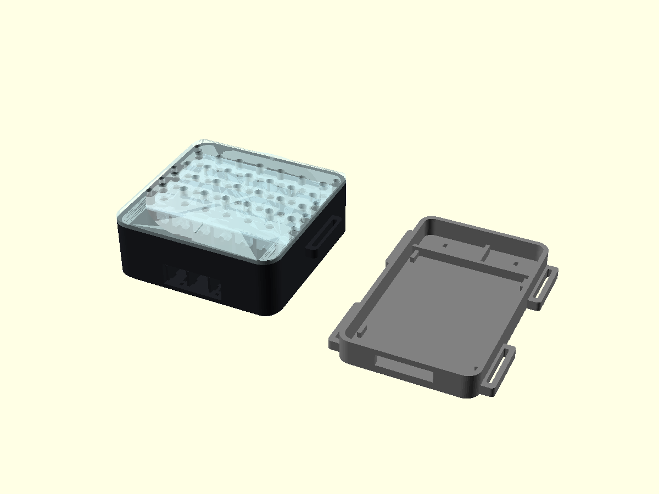
cad/evidence/geometry-preview.png
