MartinPuli/feel/cad/production/evidence/section-col3.png

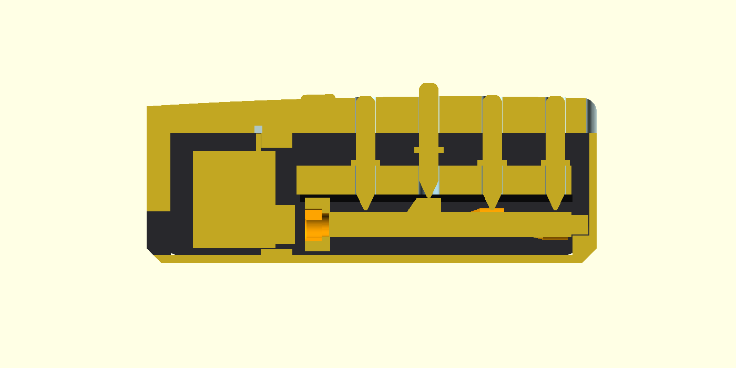
cad/production/evidence/section-col3.png
