MartinPuli/feel/docs/diagrams/chalk-journey-loop.webp

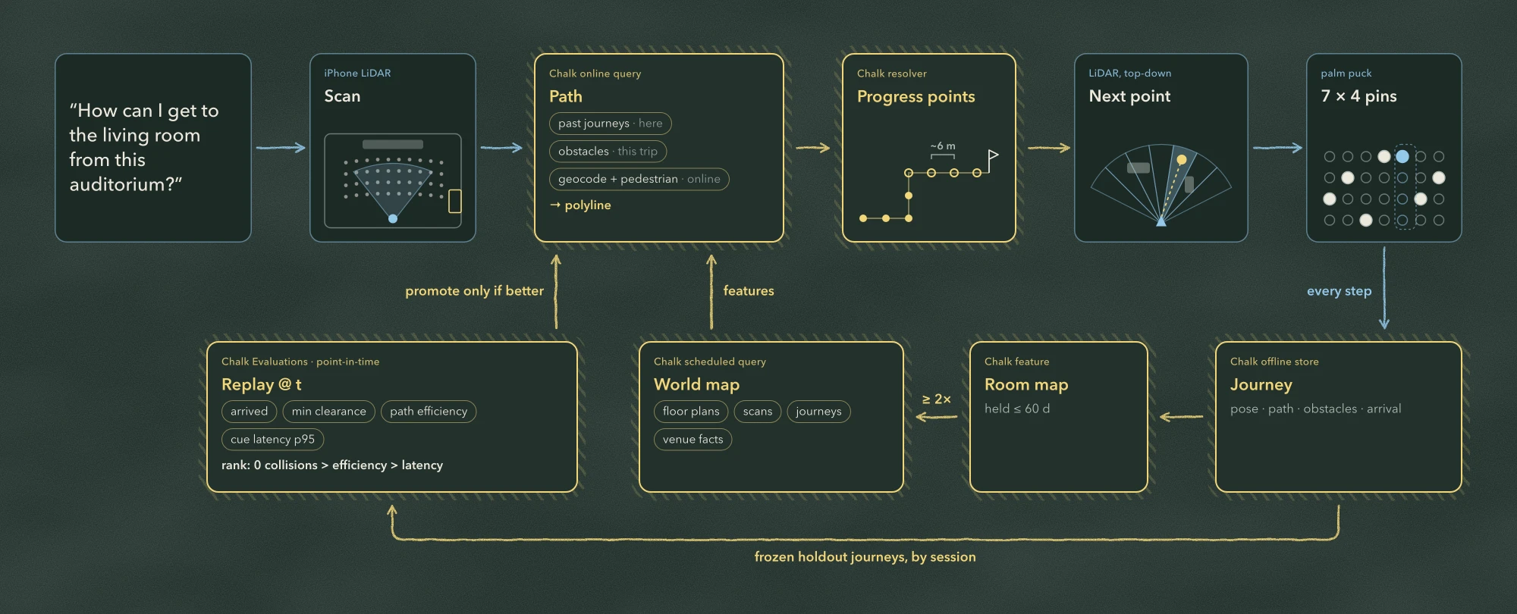
docs/diagrams/chalk-journey-loop.webp
