MartinPuli/feel/docs/evidence/chalk-production-20261017/privacy-policy.jpg

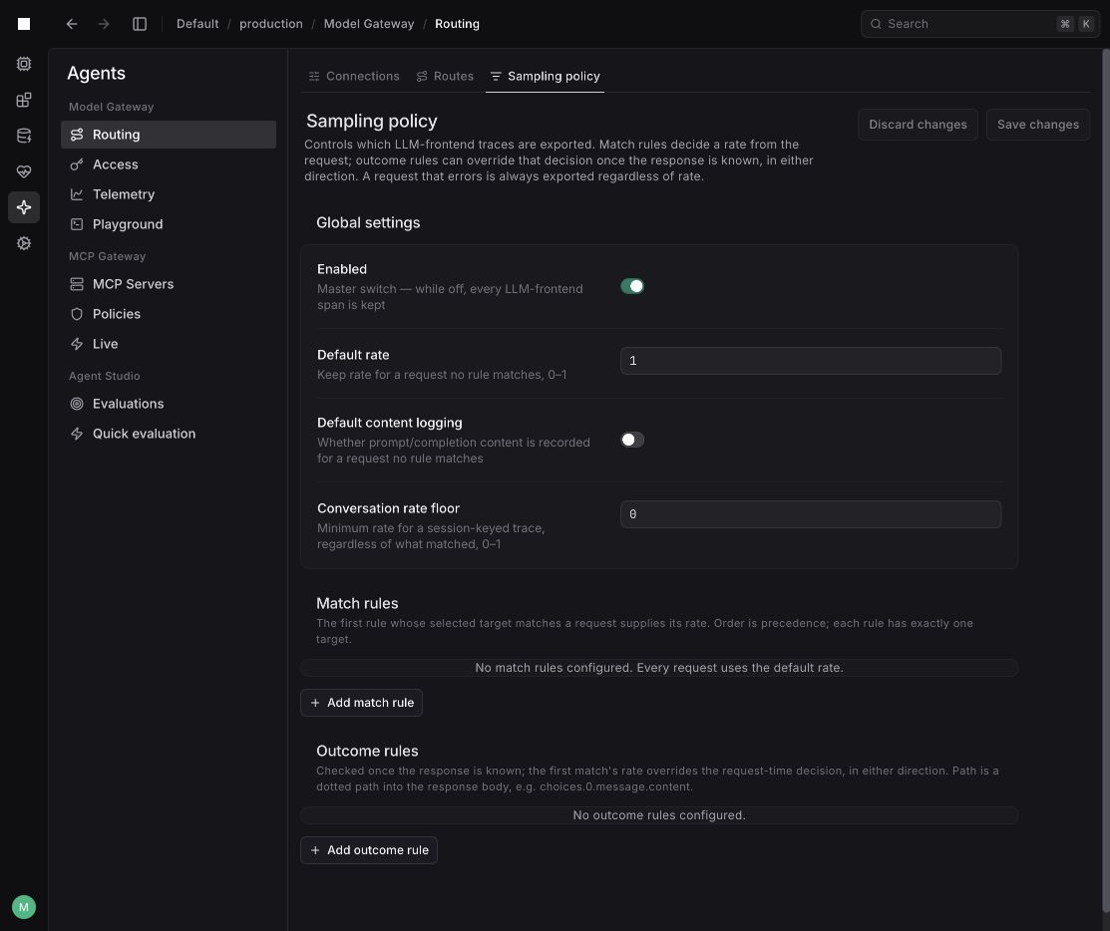
docs/evidence/chalk-production-20261017/privacy-policy.jpg
