MartinPuli/feel/docs/evidence/chalk-production-20261017/support-submitted.jpg

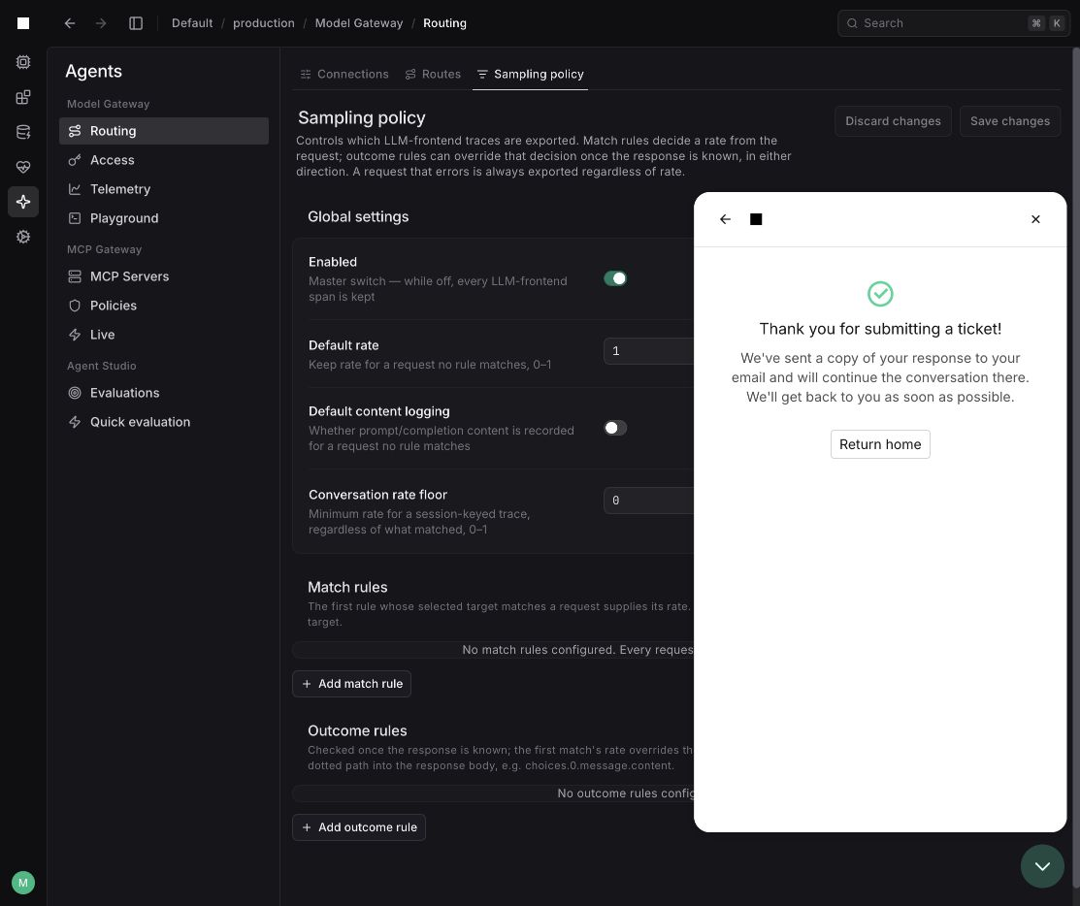
docs/evidence/chalk-production-20261017/support-submitted.jpg
