MartinPuli/feel/docs/evidence/v1-dark-ui/drawer.png

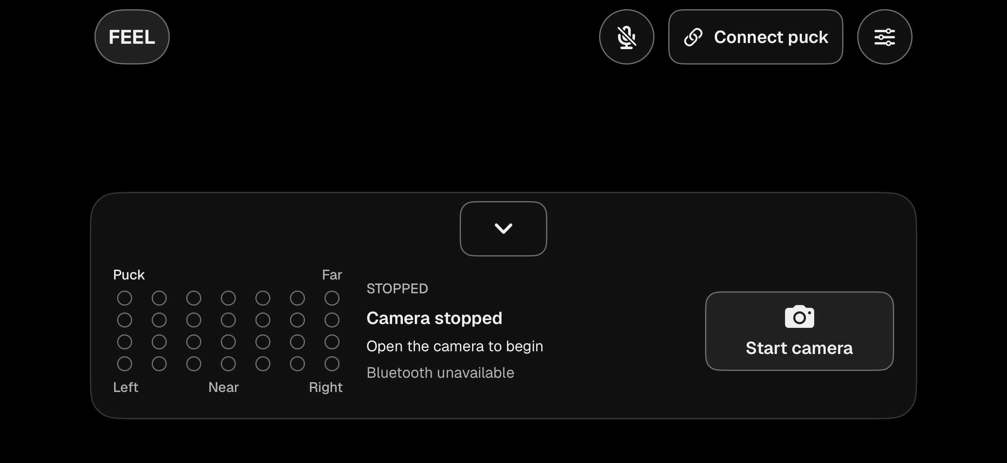
docs/evidence/v1-dark-ui/drawer.png
