MartinPuli/feel/docs/evidence/v1-dark-ui/settings.png

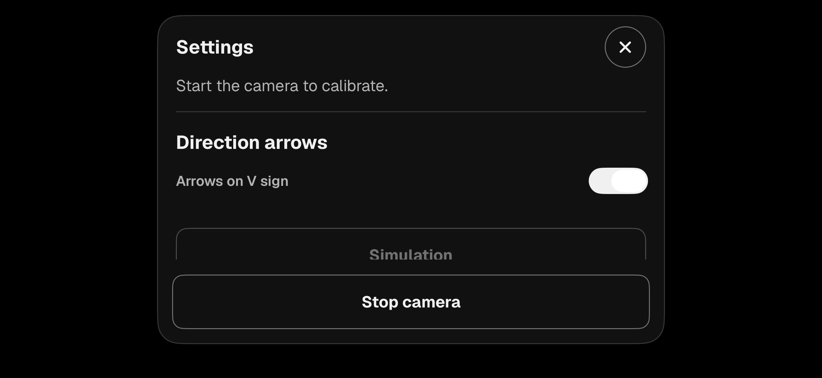
docs/evidence/v1-dark-ui/settings.png
