MartinPuli/feel/docs/evidence/v1-design/beacon-dark-accessibility-text.png

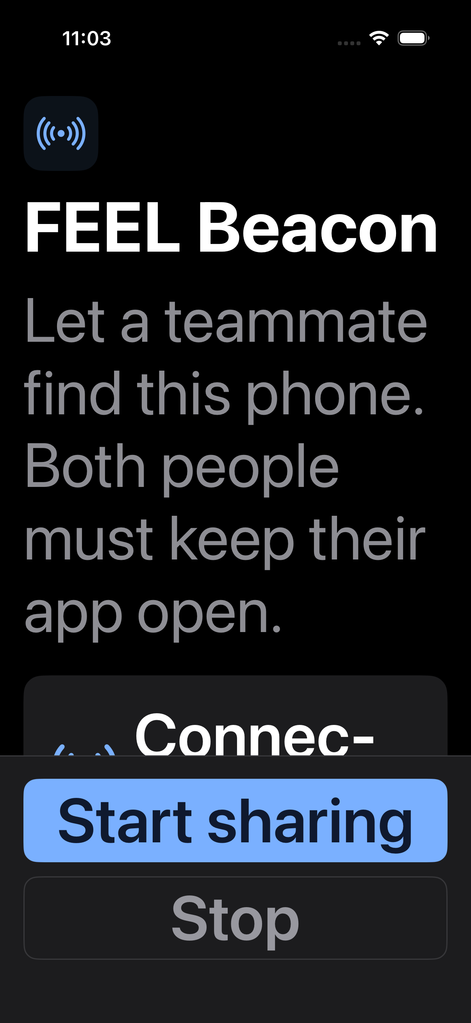
docs/evidence/v1-design/beacon-dark-accessibility-text.png
