MartinPuli/feel/docs/evidence/v1-design/lantern-before.png

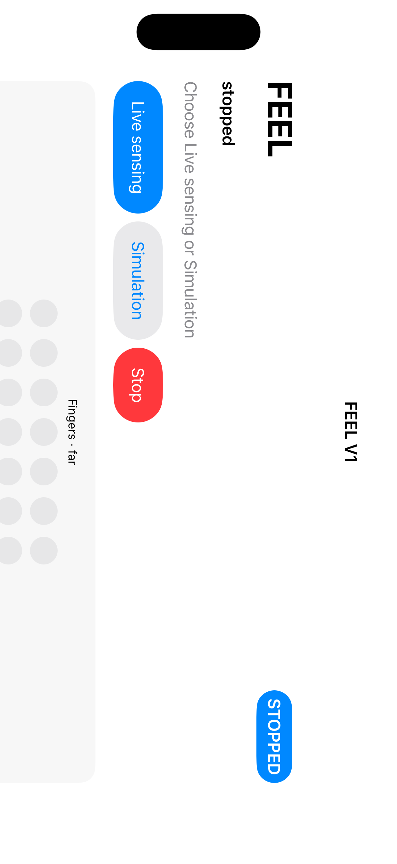
docs/evidence/v1-design/lantern-before.png
