MartinPuli/feel/docs/evidence/v1-design/lantern-dark-accessibility-text.png

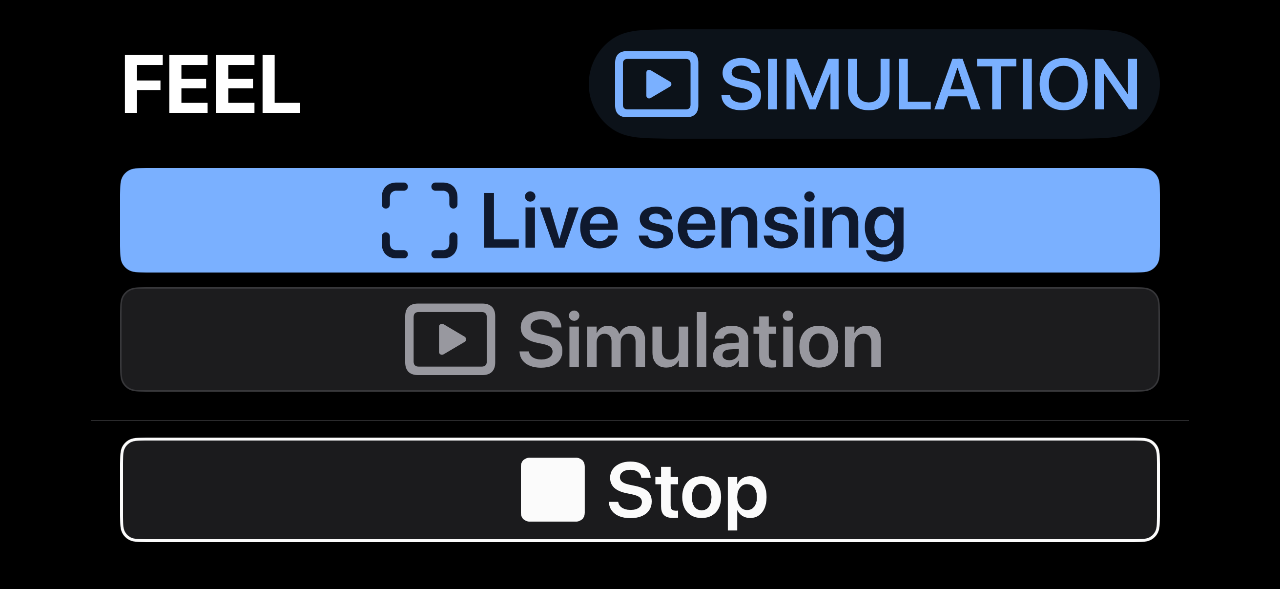
docs/evidence/v1-design/lantern-dark-accessibility-text.png
