MartinPuli/feel/docs/evidence/v1-drawer/camera-accessibility-text.png

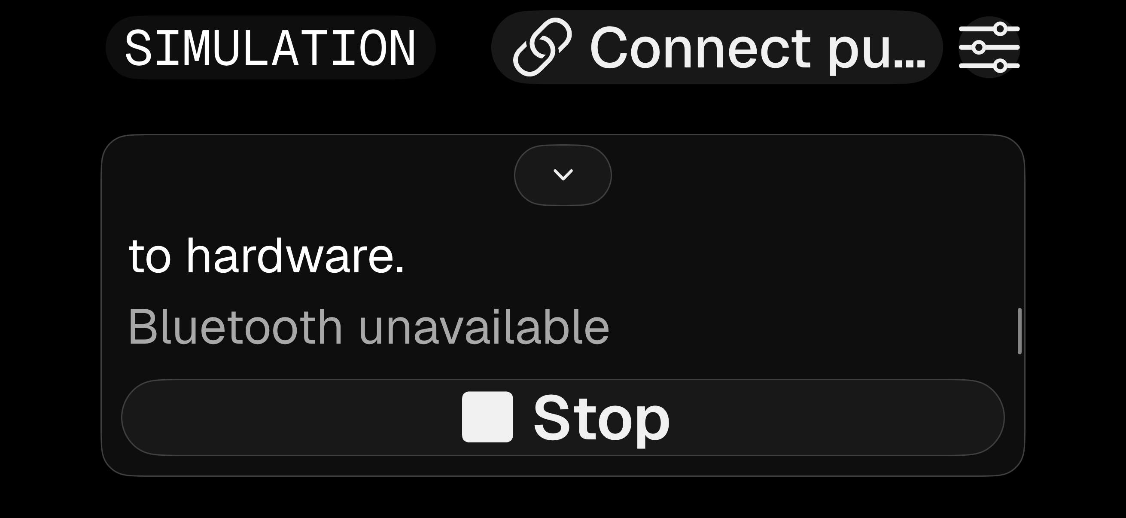
docs/evidence/v1-drawer/camera-accessibility-text.png
