MartinPuli/feel/docs/evidence/v1-drawer/camera-simulation.png

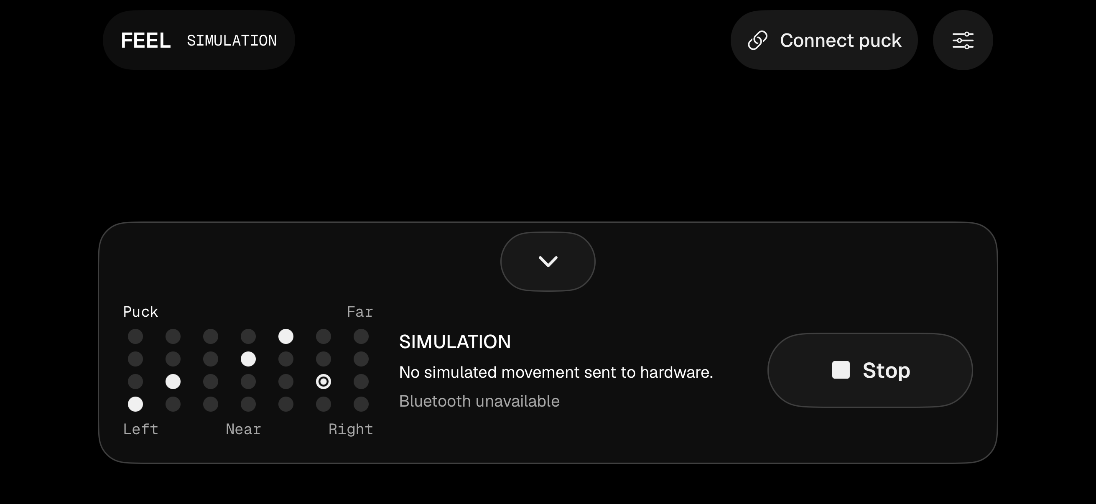
docs/evidence/v1-drawer/camera-simulation.png
