MartinPuli/feel/docs/evidence/v1-drawer/drawer-collapsed-active.png

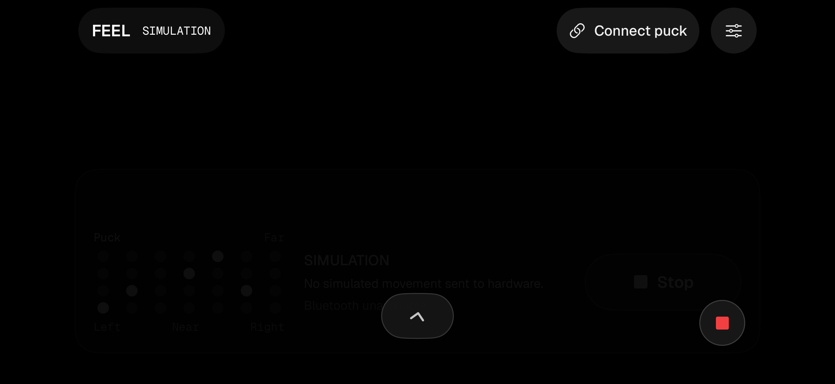
docs/evidence/v1-drawer/drawer-collapsed-active.png
