MartinPuli/feel/docs/evidence/v1-drawer/drawer-collapsed.png

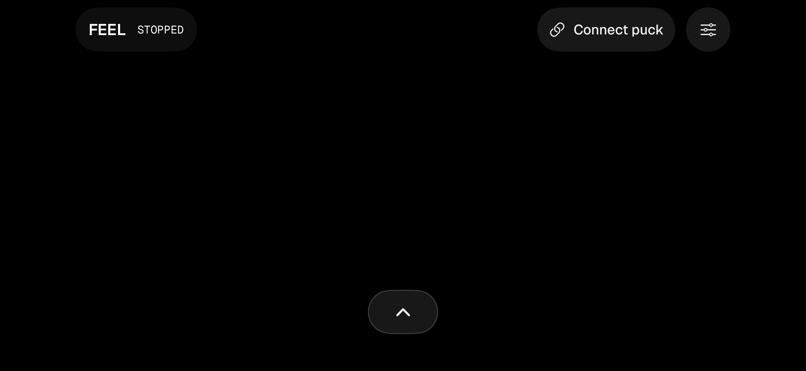
docs/evidence/v1-drawer/drawer-collapsed.png
