MartinPuli/feel/docs/evidence/v1-drawer/drawer-settings-modal.png

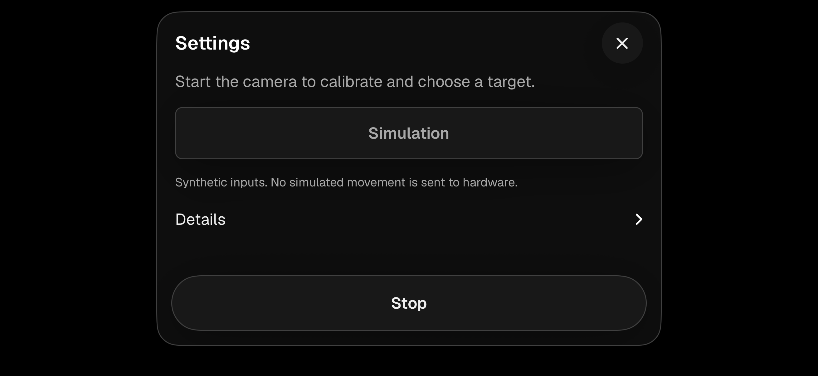
docs/evidence/v1-drawer/drawer-settings-modal.png
