MartinPuli/feel/docs/evidence/v1-simple/beacon-accessibility-text.png

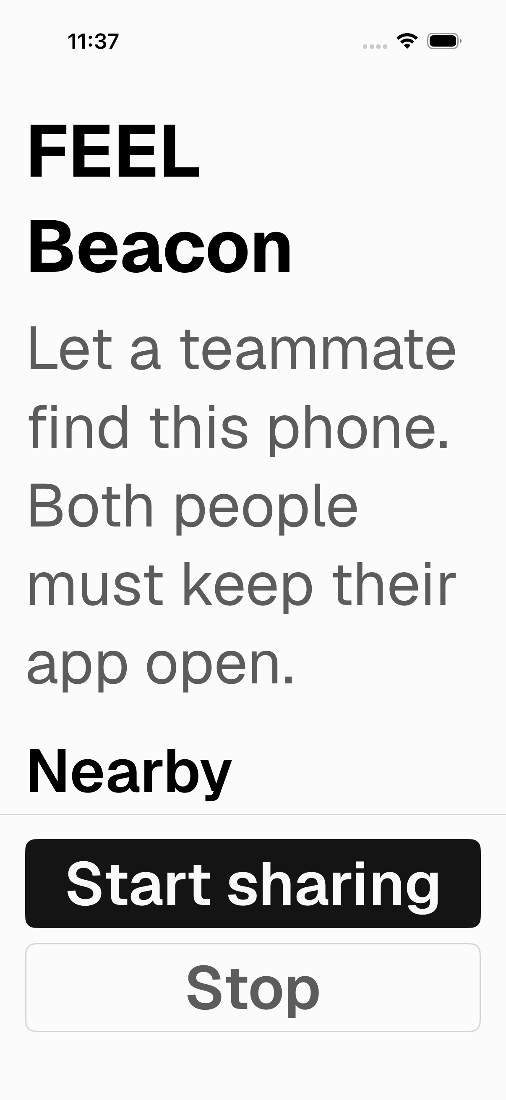
docs/evidence/v1-simple/beacon-accessibility-text.png
