MartinPuli/feel/docs/evidence/v1-simple/beacon-light.png

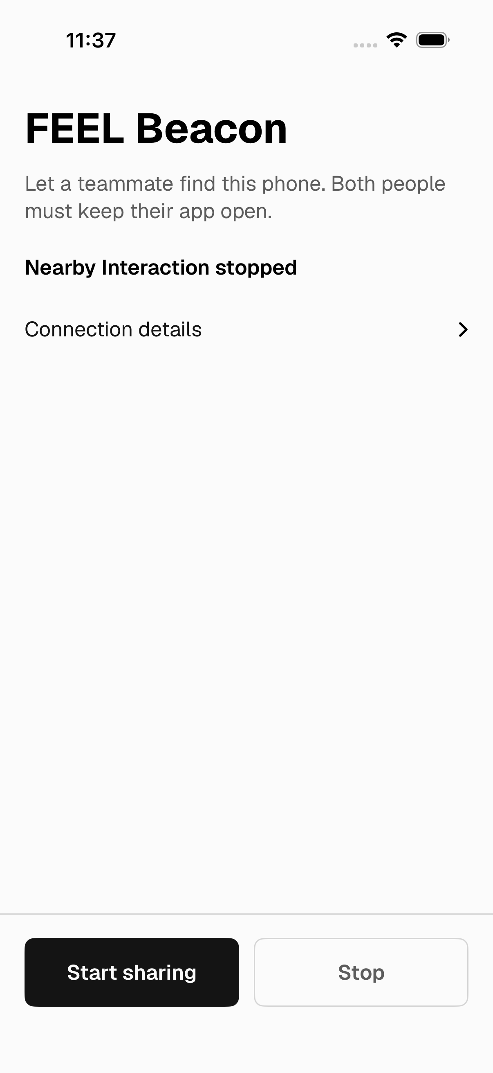
docs/evidence/v1-simple/beacon-light.png
