MartinPuli/feel/docs/evidence/v1-simple/lantern-accessibility-text.png

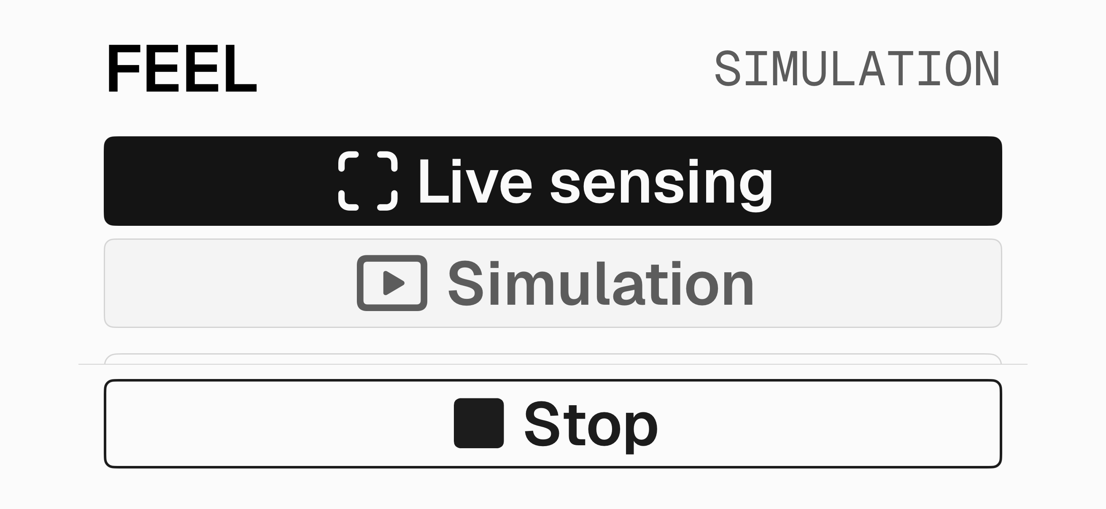
docs/evidence/v1-simple/lantern-accessibility-text.png
