MartinPuli/feel/docs/evidence/v1-simple/lantern-light-simulation.png

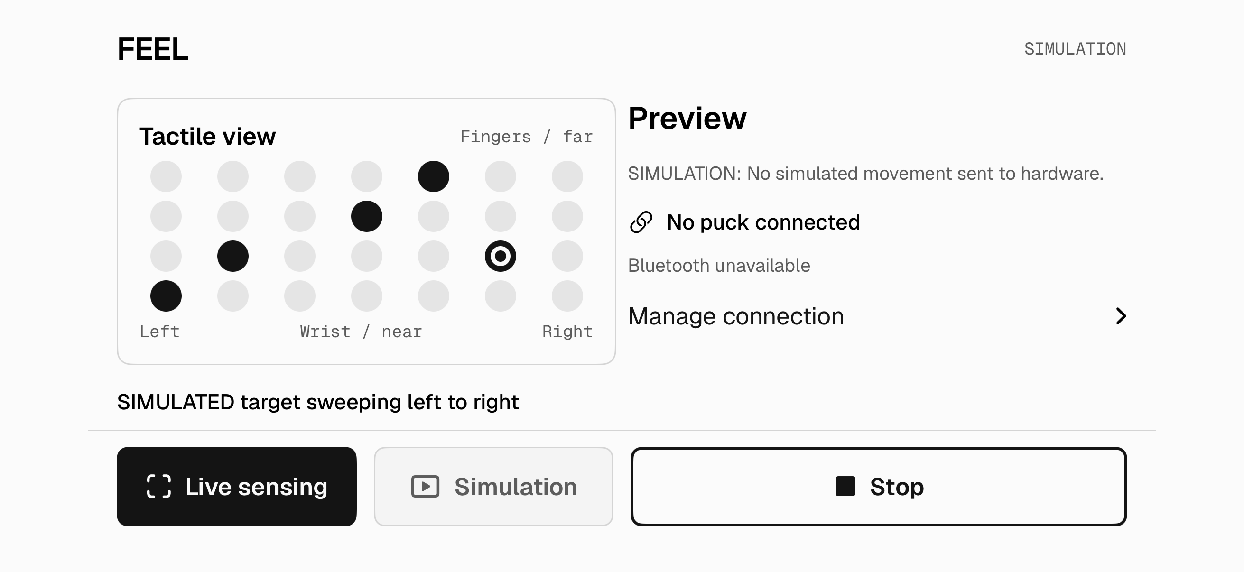
docs/evidence/v1-simple/lantern-light-simulation.png
