MartinPuli/feel/docs/evidence/v1-simple/lantern-light-stopped.png

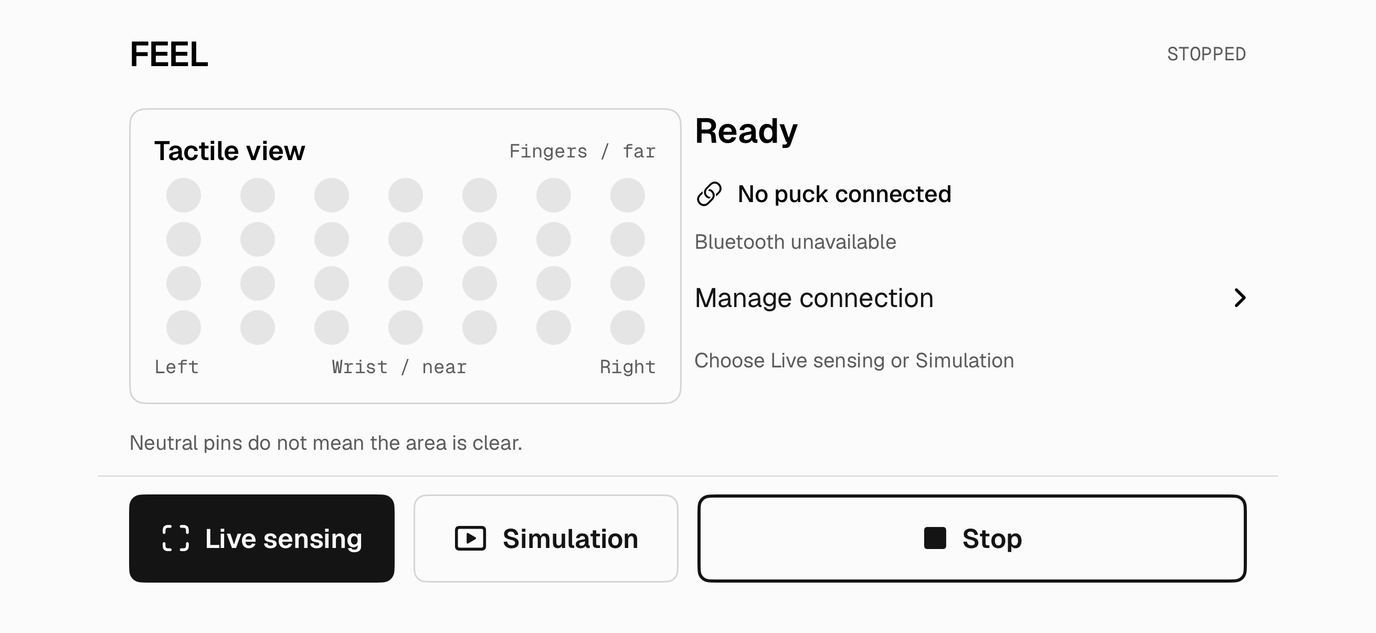
docs/evidence/v1-simple/lantern-light-stopped.png
