MartinPuli/feel/docs/evidence/v1-vercel/beacon-accessibility-text.png

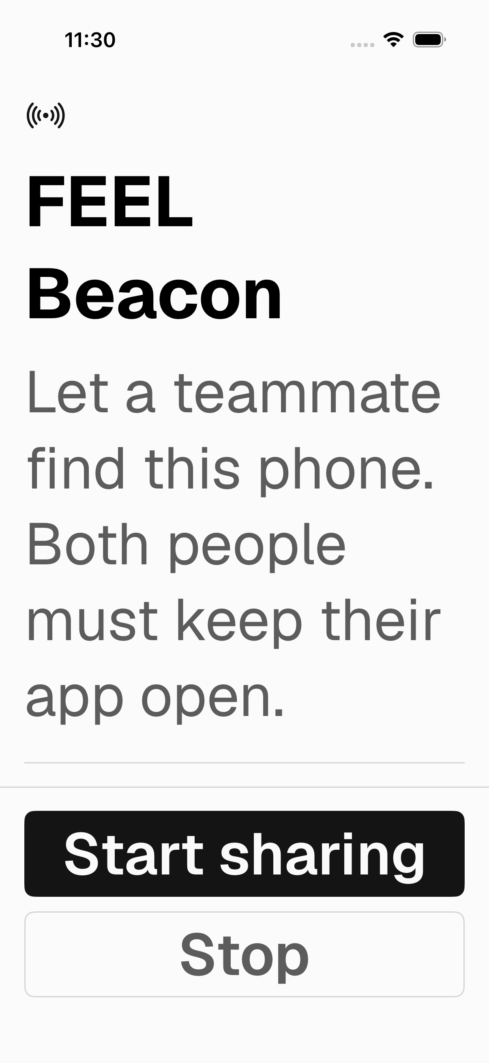
docs/evidence/v1-vercel/beacon-accessibility-text.png
