MartinPuli/feel/docs/evidence/v1-vercel/beacon-dark.png

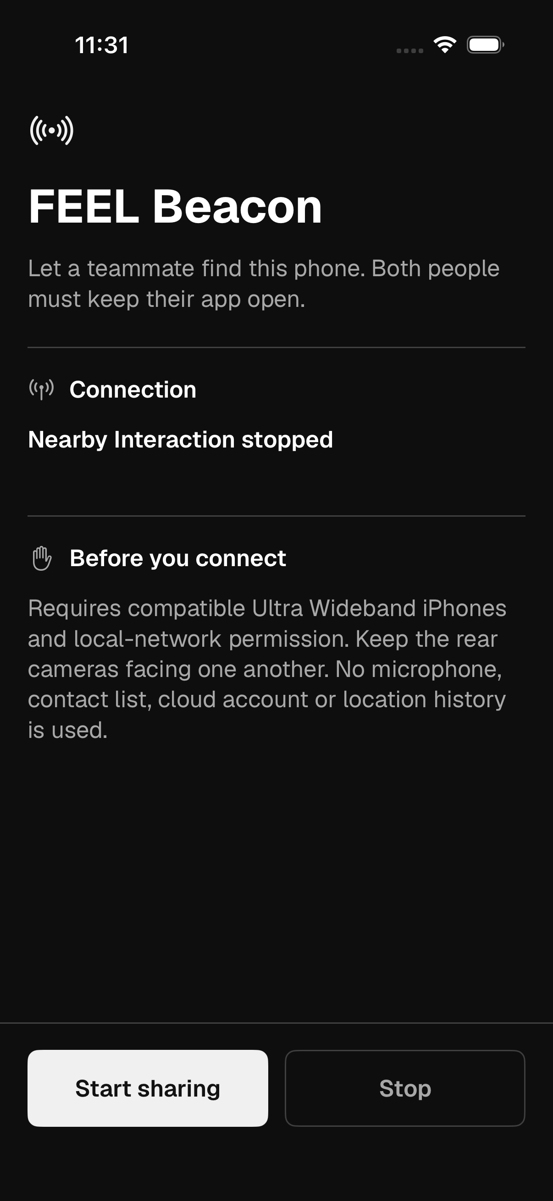
docs/evidence/v1-vercel/beacon-dark.png
