MartinPuli/feel/docs/evidence/v1-vercel/beacon-light.png

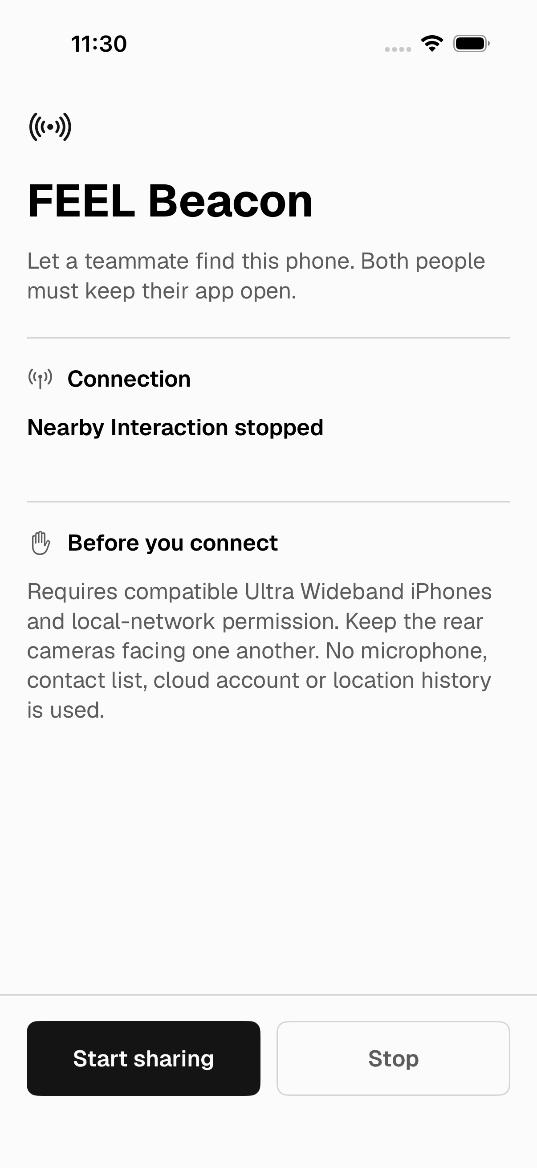
docs/evidence/v1-vercel/beacon-light.png
