MartinPuli/feel/docs/evidence/v1-vercel/lantern-dark-simulation.png

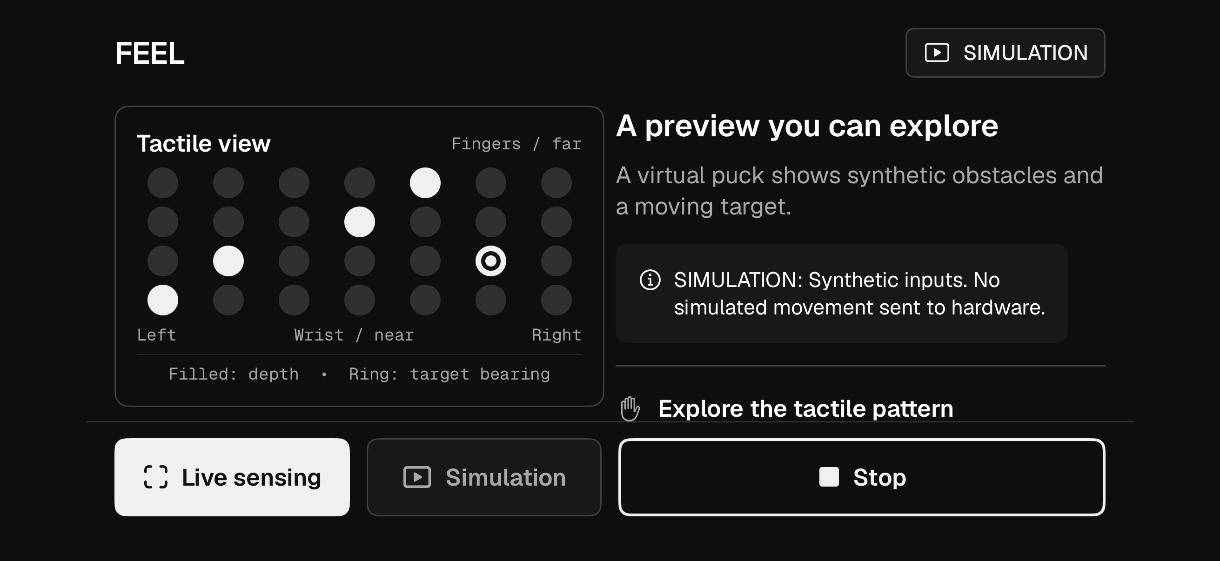
docs/evidence/v1-vercel/lantern-dark-simulation.png
