MartinPuli/feel/docs/evidence/v1-vercel/lantern-dark-stopped.png

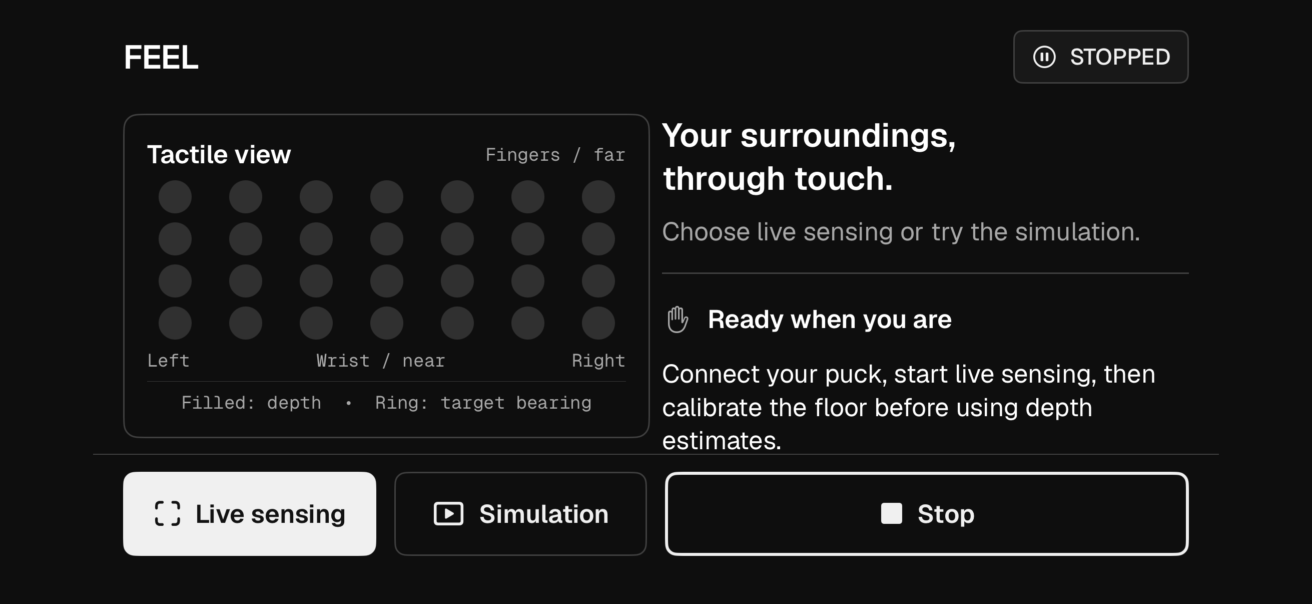
docs/evidence/v1-vercel/lantern-dark-stopped.png
