MartinPuli/feel/docs/evidence/v1-vercel/lantern-light-simulation.png

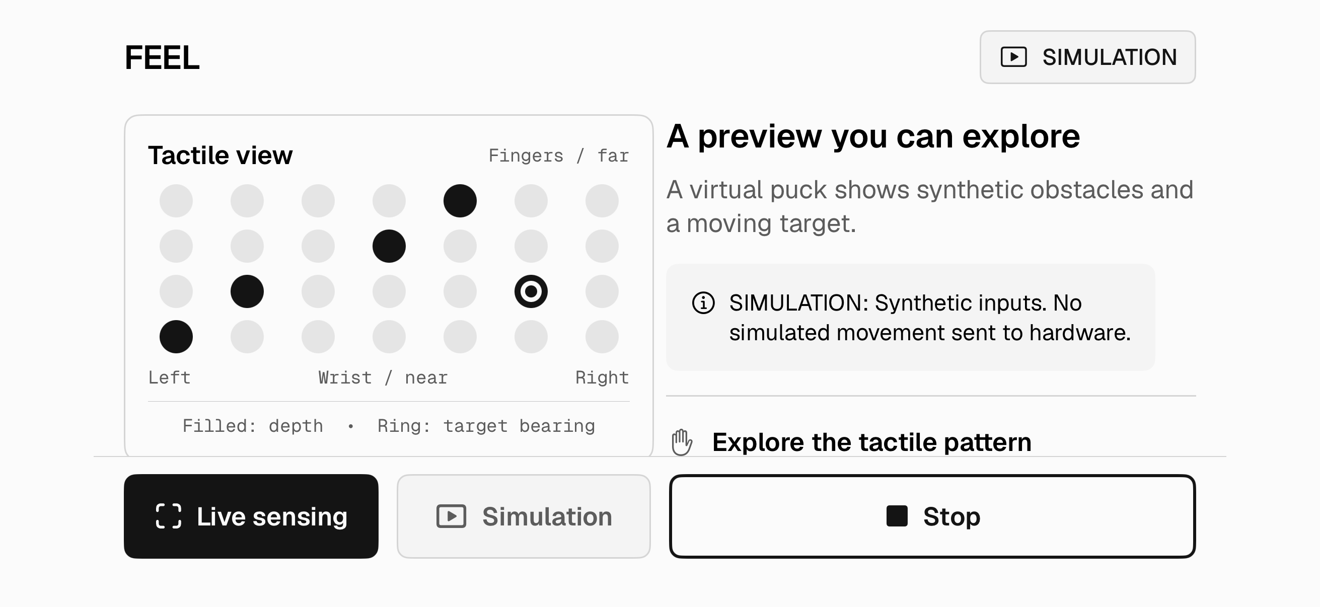
docs/evidence/v1-vercel/lantern-light-simulation.png
