MartinPuli/feel/docs/evidence/v1-vercel/lantern-light-stopped.png

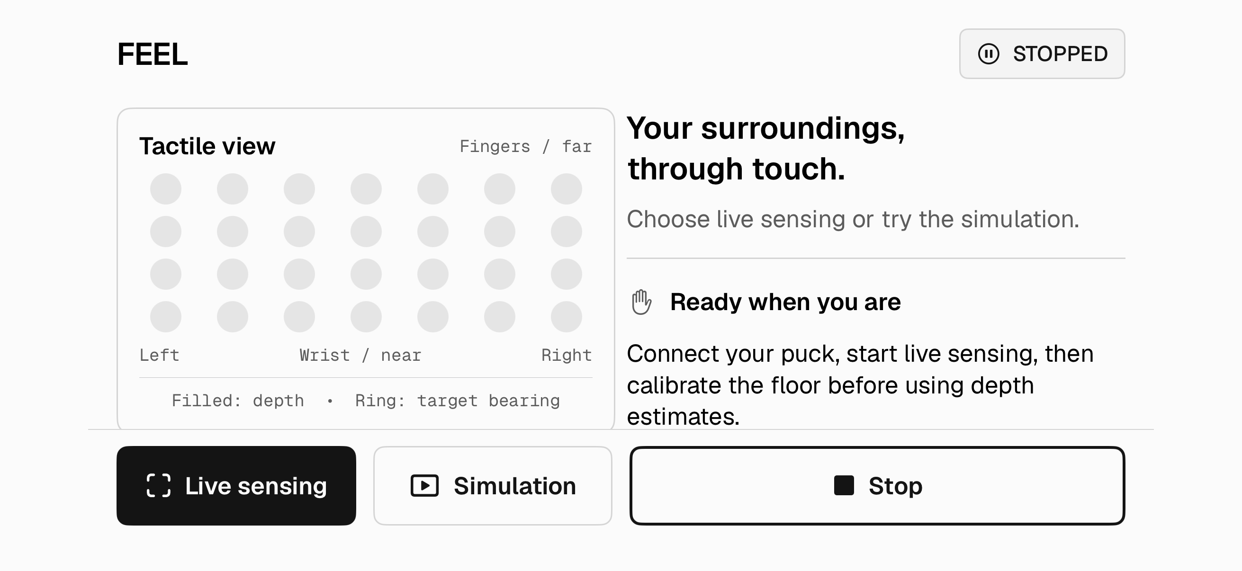
docs/evidence/v1-vercel/lantern-light-stopped.png
