MartinPuli/feel/docs/evidence/v1-voice/camera.png

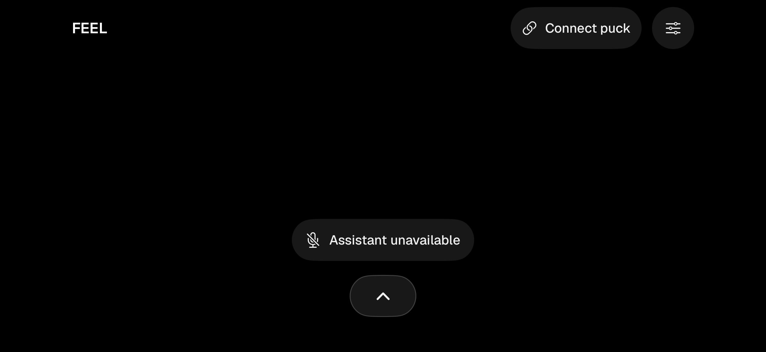
docs/evidence/v1-voice/camera.png
