MartinPuli/feel/docs/evidence/v1-voice/large-text.png

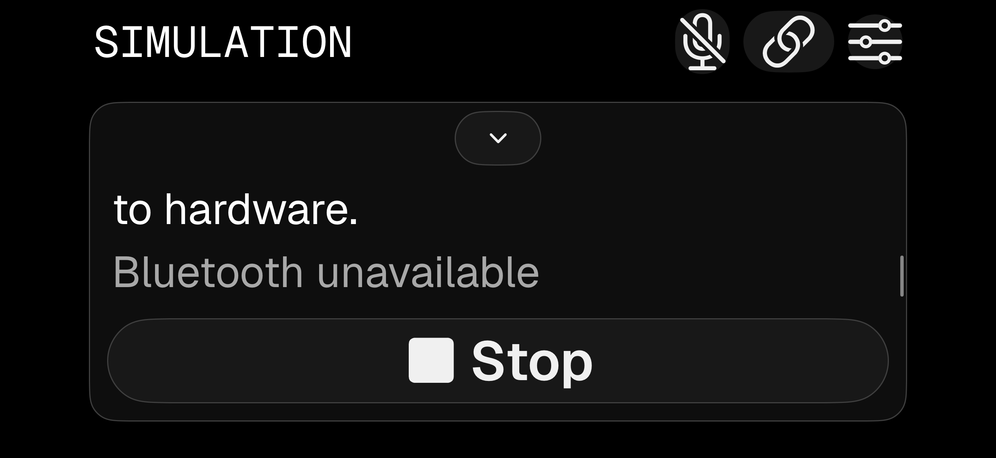
docs/evidence/v1-voice/large-text.png
