MartinPuli/feel/docs/evidence/v1/cad-viewer.png

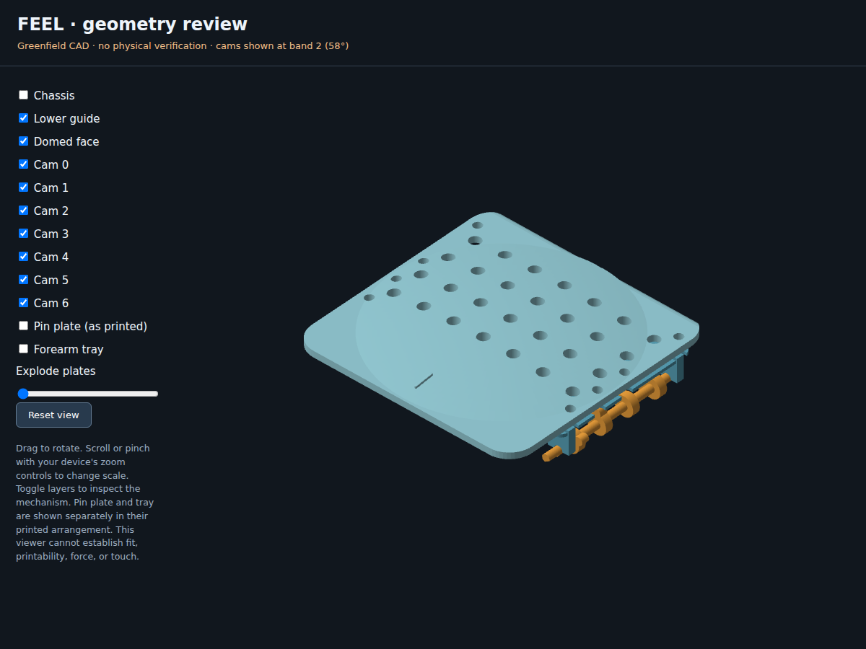
docs/evidence/v1/cad-viewer.png
