MartinPuli/feel/docs/evidence/v1/replay-desktop.png

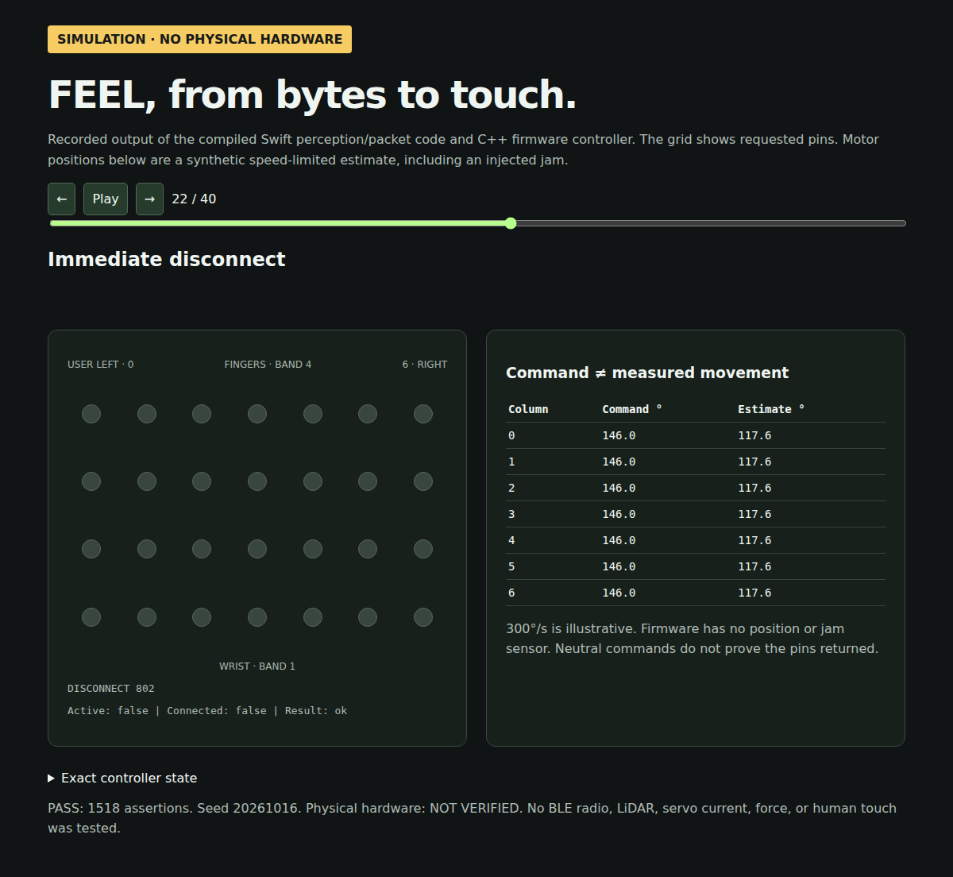
docs/evidence/v1/replay-desktop.png
