MartinPuli/feel/docs/media/puck-explode.gif

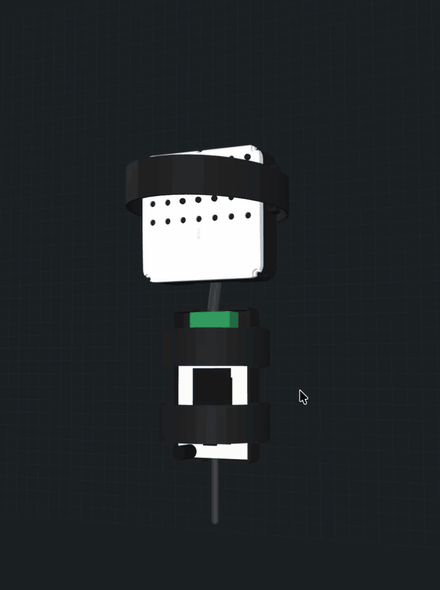
docs/media/puck-explode.gif
