MartinPuli/feel/docs/media/puck-strap-render.png

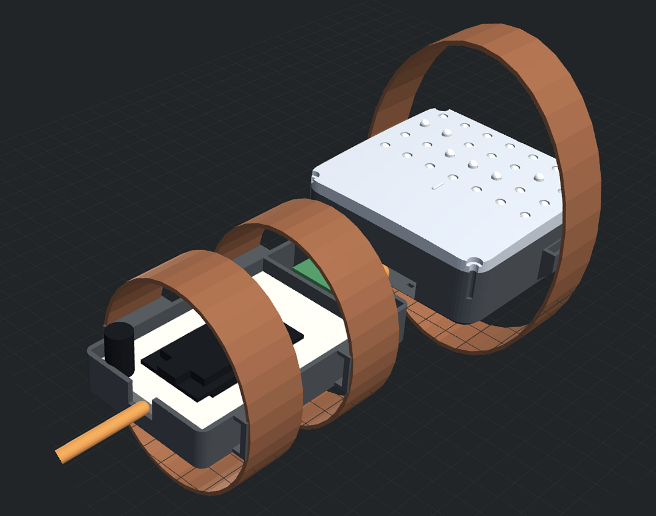
docs/media/puck-strap-render.png
