MartinPuli/feel/ios/Lantern/Resources/feel-tag-01.png

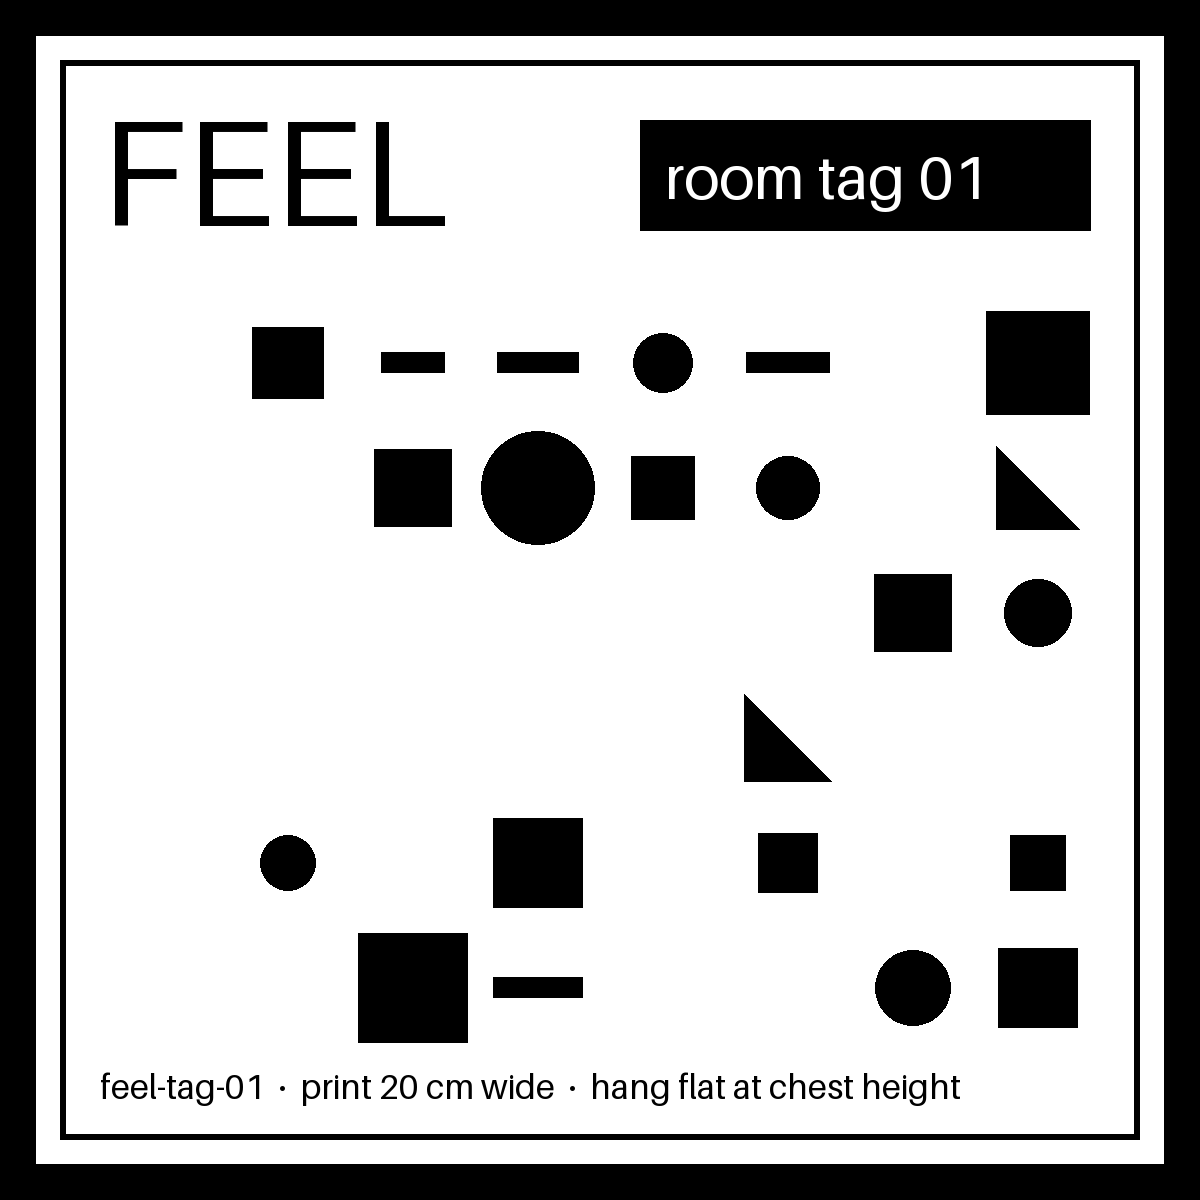
ios/Lantern/Resources/feel-tag-01.png
