MartinPuli/feel/(list of files, cad)

Other CAD files:
cad/production/params.scad
