MartinPuli/feel/cad/production/evidence/assembly.png

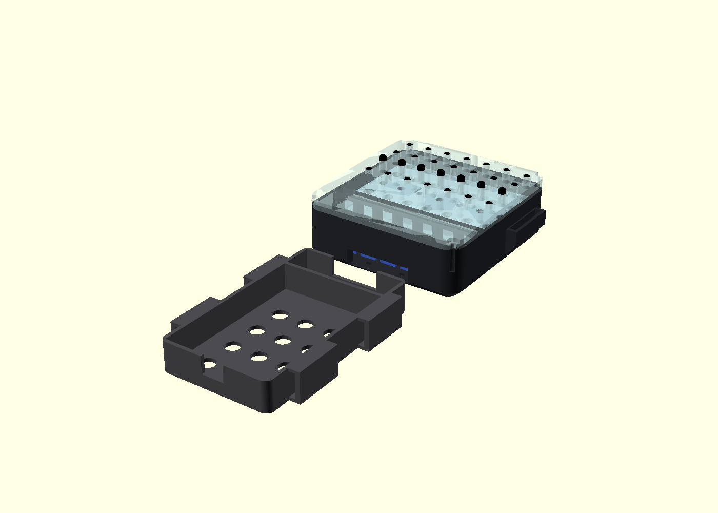
cad/production/evidence/assembly.png
