MartinPuli/feel/docs/chalk-usage.png

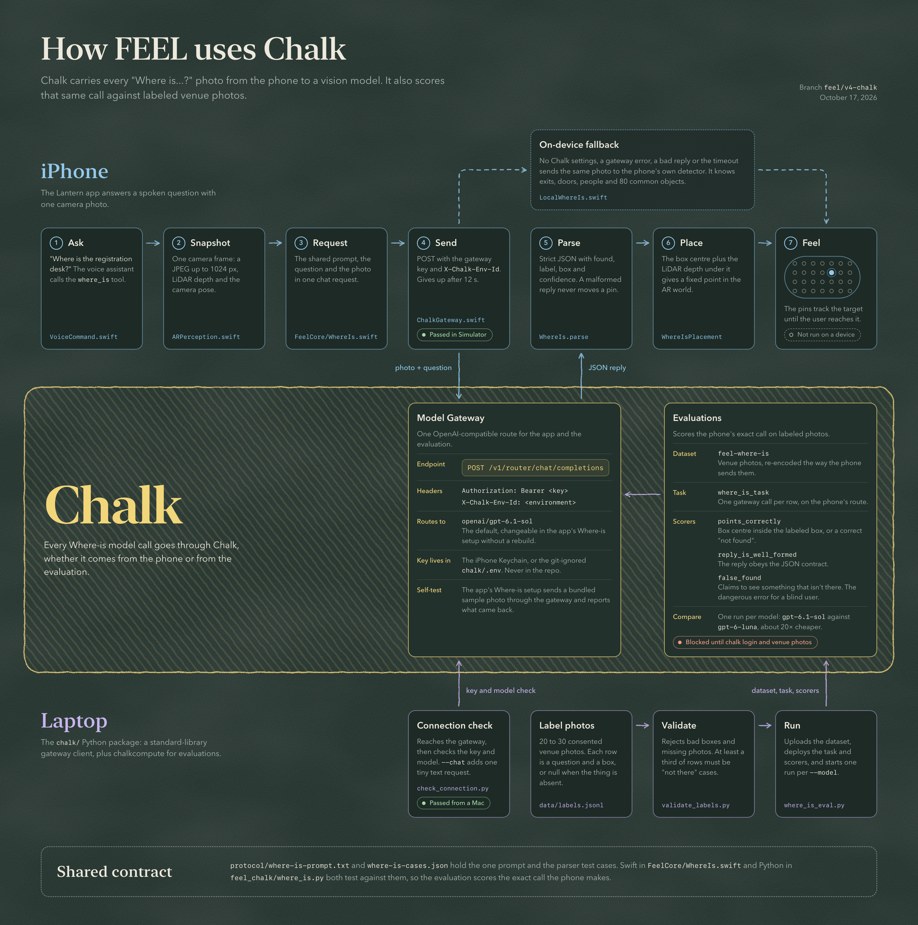
docs/chalk-usage.png
