MartinPuli/feel/docs/evidence/v1-voice/assistant-setup.png

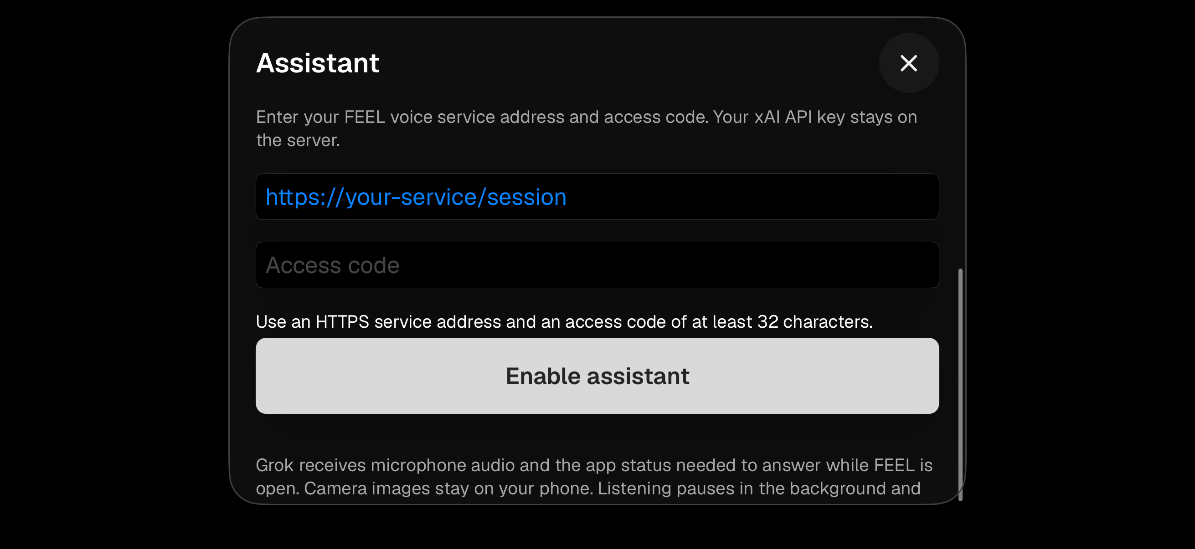
docs/evidence/v1-voice/assistant-setup.png
