MartinPuli/feel/validation/production/viewer.html

SIMULATION · NO PHYSICAL HARDWARE

# FEEL, from bytes to touch.

Recorded output of the compiled Swift perception/packet code and C++ firmware controller. The grid shows six active columns; wire slot 0 is reserved and has no physical output. Motor positions below are a synthetic speed-limited estimate, including an injected jam.

←Play→

USER LEFT · 1FINGERS · BAND 46 · RIGHT

WRIST · BAND 1

### Command ≠ measured movement

Column | Command ° | Estimate °

300°/s is illustrative. Firmware has no position or jam sensor. Neutral commands do not prove the pins returned.

Exact controller state
