MartinPuli/feel/services/chalk/requirements-evaluation.txt

# Optional hosted evaluation dependencies; server itself uses only stdlib.
chalkcompute==2.13.7
pyarrow==26.0.0
