MartinPuli/feel/docs/evidence/v1-camera/validation.txt

V1 camera-first interface — 2026-10-16, build 1.0.0 (4)

PASS: clean simulator build, Xcode 26.6 / iPhone 17 Pro, iOS 26.5.
PASS: 5 Lantern integration tests, zero failures, including ARSession and
      perception delegate identity after attaching the camera preview.
PASS: 5 Lantern UI tests, zero failures:
      - camera controls and simulation/neutral Stop;
      - background/foreground does not restart;
      - settings/connection dismissal does not restart;
      - Stop is reachable in both sheets and at largest accessibility text;
      - unavailable camera/permission recovery remains visible.
PASS: signed native device builds for Lantern and Beacon, build 4.
PASS: Lantern signature verified with codesign --verify --deep --strict.
PASS: independent review. Calibration recovery status was added inside Settings
      after review found that the main status was hidden behind the sheet.
PASS: largest-text test repeated after making the fixed footer opaque,
      preventing scrolling text from showing through behind Stop.
PASS: default/large-text screenshots inspected. Camera is off in simulation;
      no synthetic photograph is shown as live video.

The first incremental run invoked the previous UI test entrypoints and failed
because Simulation had moved into Settings. A clean build then compiled and
executed the current five UI tests successfully. No assertions were removed to
hide a runtime failure. The simulation check still verifies explicit labeling,
no simulated hardware movement, and all neutral bands after Stop.

The shared core and Beacon UI behavior are unchanged; their prior validation
remains recorded in v1-vercel and v1-simple. No claim of fresh physical testing.

Historical build-time state: installation was pending while the iPhone was
unavailable. The October 17 installation update below supersedes that state.
Original signed-app paths (temporary, may no longer exist):
/tmp/feel-vercel-device/Build/Products/Debug-iphoneos/Lantern.app
/tmp/feel-vercel-device/Build/Products/Debug-iphoneos/Beacon.app

Physical checks still needed: actual camera image/mount orientation, calibrated
live depth, dot/packet correspondence to physical pins, BLE connection, and UWB.

Commands:
xcodegen generate --spec ios/project.yml
xcodebuild -project ios/Lantern.xcodeproj -scheme Lantern -destination
  'platform=iOS Simulator,id=<available simulator>' -derivedDataPath
  /tmp/feel-v1-design-build CODE_SIGNING_ALLOWED=NO clean test
xcodebuild -project ios/Lantern.xcodeproj -scheme <Lantern|Beacon>
  -configuration Debug -destination 'generic/platform=iOS' -derivedDataPath
  /tmp/feel-vercel-device DEVELOPMENT_TEAM=<existing team>
  -allowProvisioningUpdates build

Installation update — 2026-10-17
PASS: fresh signed Lantern build from main a4c141e, detector model included.
PASS: devicectl device install app using the connected device hardware UDID.
PASS: devicectl device process launch org.feel.hackharvard.lantern.
PASS: device info apps --bundle-id org.feel.hackharvard.lantern confirms
      FEEL, version 1.0.0, bundle version 4.
The first install attempt using the stored CoreDevice identifier failed with
error 1011. Retrying with the hardware UDID established the developer tunnel
and succeeded. No unpairing or device reset was needed.
Current local artifact: /tmp/feel-camera-install/Build/Products/Debug-iphoneos/Lantern.app
Beacon was not installed in this update. Camera image, calibration and physical
sensing/actuation remain unverified; launch success is not evidence of those.
