MartinPuli/feel/docs/TODO.md

## Every todo, in priority, now to demo

**Tonight, before the venue closes**
1. Measure servo travel precisely. Text Isabella `shaft3` or `shafts fine`. Nothing else matters until this is done.
2. Foam: three 84 × 47 sheets, 28 holes each, plus two spares. In progress.
3. Prep seven servos: lower ear clipped, horn arm cut to a 2 mm stub, horn screwed on, plug labelled 1 to 7.
4. One prepared servo into the shell: through the tunnel, ear against the bulkhead, no forcing. File the tunnel if tight.
5. Ream 28 lid holes and 28 guide holes.
6. Pins off the sprue in grid order, stubs cleaned, shafts rolled on 400 grit, each falls through its two holes.
7. Guide plate in, pins in, foam in, lid taped. Every pin presses and returns.
8. Seven-servo header board: headers, B R W tape, 5 V rail, capacitor, common ground, GPIO 32 33 25 26 27 14 13.
9. Rail checked with the multimeter before any servo is plugged in.
10. Gate 1 on the test column: `TEST`, `PARADE`, thumb test, tap. Then the feel test, ten calls palm, ten fingertip, someone else typing.
11. Phone connected over Bluetooth, live sensing on, walking toward the phone steps the test column through the bands.
12. Straps cut: one palm, two forearm. Breadboard into the pack tray, leads reach from shell to tray.
13. Devpost skeleton, demo script, and who says what, drafted while hands are busy.
14. Charge the bank and every phone overnight.
15. Sleep.

**Saturday morning**
16. Hardware store at opening: M3 × 12 screws or #4 × 1/2" sheet-metal, eight plus spares.
17. Pulse-mode decision from last night's feel scores. If palm scores were poor and fingertip good, pulse goes into the firmware this morning.
18. Get the prints the moment the makerspace opens. Anyone with access before 3 PM.

**Saturday afternoon, the build**
19. Seven shafts in: stub into the far slot, servo forward until the horn seats, shaft rolls stiff like a geared knob.
20. Guide, pins, foam, lid, screws.
21. Power on, `TEST`. Calibrate each column with `CAL c o` until band 1 is fully up and the gaps are fully down. `CAL SAVE`.
22. `PARADE` for five minutes. Fix the column that binds; there will be one.
23. Phone end to end: walk a teammate left to right, closer and farther, two people with a gap. Tune band edges if the far band never fires indoors.
24. Highlight: "find the door" taps a pin. Beacon app on a second iPhone for "find a person" if a UWB phone exists; otherwise cut that line from the demo.
25. Ten minutes on the bank, untethered, worn on the forearm. Bank stays awake, nothing browns out.
26. The three numbers: first correct column untrained, hallway course with and without, depth-frame-to-pin latency.

**Saturday night**
27. Video: 60 to 90 seconds, pins visible, one blind-folded tester calling positions.
28. Devpost text, photos, the honest limits section. Submit before you sleep, edit in the morning.
29. Pitch rehearsal, three minutes, each person their part.
30. Spares bag: two pins, one shaft, one foam sheet, hot glue, tape, screws, the multimeter.

**Sunday**
31. Final Devpost edit before 8 AM.
32. At the table: wall supply, puck on a stand, a teammate ready to walk. Fallbacks ready: six columns if one dies, the app's simulation mode if the puck dies.
