MartinPuli/feel/(commit log)

2026-10-16 Prepare FEEL V2 validation, fault replay, and hardware handoff; record missing source blocker
    [feel_model.py, run_scenarios.py]
2026-10-16 Build FEEL V1 greenfield foundation and add Mac ESP32 setup guide
    Recreates Swift apps, ESP32 firmware, CAD and production replay from the v7 specification. Available local checks pass; Apple platform and physical device validation remain pending.
    Published at the user's explicit request. Source tree matches local reviewed snapshot da194eccda47fd1c021084c281ce948b4eac16d7.
    [cam-lifts.csv, fit_probe.scad, lib.scad, pack.scad, params.scad, profile.scad, puck.scad, test_column.scad]
2026-10-17 Adapt FS0307 cam and firmware to nominal 120-degree travel
    [cam-lifts.csv, params.scad, puck.scad, test_column.scad, viewer.scad]
2026-10-17 Use English for setup guides and repository instructions
    Translate the Mac/ESP32 and hardware preparation guides, rename the latter to HARDWARE-PREPARATION.md, and translate the README setup link. Preserve command behavior, technical constraints, and reference URLs. Record English as the repository language.
    Validation: independent translation review, unchanged command blocks except the translated port placeholder, link checks, and git diff --check.
2026-10-17 Add bounded five-second midpoint servo test and record USB trials
2026-10-17 Connect one center-sector servo to live FEEL BLE packets
2026-10-17 Add opt-in nominal120 live mapping for the single GPIO32 servo
2026-10-17 Prepare seven-servo V1 production profile and setup guide
2026-10-17 Record seven-servo preparation tests and deployment prerequisites [skip ci]
2026-10-17 Make V1 camera-first with live puck feedback and fewer controls [skip ci]
2026-10-17 Record camera-first app installation and launch on iPhone [skip ci]
2026-10-17 Add collapsible camera controls and floating V1 panels [skip ci]
2026-10-17 battery + cad + todo
    [lib.scad, params.scad, puck.scad]
2026-10-17 feat(app): frame snapshot and Where-is service through Chalk
2026-10-17 feat(app): OpenAI Realtime as a second voice service, typed requests, V4 status and device checklist
2026-10-17 feat(app): on-device Where-is fallback, review fix pass, docs
    Where-is asks Chalk first and, without Chalk settings or when the
    gateway fails or exceeds 12 s, runs the same photo through the phone's
    own detector (LocalWhereIs → ObjectDetector): Vision text for EXIT
    signs, rectangles for door candidates, people, and the bundled Core ML
    detector for chairs and common objects. The user's words are matched
    against a fixed vocabulary (FeelCore LocalVocabulary) and name the
    held target; unknown things get a spoken explanation. The "needs Chalk
    setup" refusal is gone; the sample-photo self-test stays Chalk-only.
    Review fix pass (fresh-context review of the branch), each test-first:
    a new ask cle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
2026-10-17 pin semantic recognization + detection-box span (multiple pins) + hand recognition
2026-10-17 ui: strip explanatory copy, collapse the optional Chalk row
    The Assistant panel keeps its controls (status, typed request, two
    toggles, the one-time connection) and loses the four explanatory
    paragraphs; guidance moves into accessibility hints. The Chalk
    settings for Where-is fold into one collapsed row ("Where-is:
    on-device only" / "Where-is: Chalk ready"). The camera settings,
    puck and teammate panels drop their footnotes; the Details disclosure
    keeps only the packet bytes. The duplicate "Assistant settings"
    button is gone.
    UI tests: the Where-is test expands the row first; 8/8 pass.
2026-10-17 Use quiet dark camera controls and floating panels [skip ci]
2026-10-17 Test device audio recovery separately from simulator fallback [skip ci]
2026-10-17 puck testing reallife
    [lib.scad, params.scad, puck.scad]
2026-10-17 Document Chalk offline limits and FEEL device capabilities [skip ci]
2026-10-17 Use shared 175-degree servo mapping and return empty bands to gaps
    [params.scad]
2026-10-17 Trim connected servo commands by seven degrees within pulse bounds
2026-10-17 Align pin selections to 0 58 116 and 174 degrees
    [params.scad]
2026-10-17 Apply requested fifteen-degree connected-servo trim
2026-10-17 Correct connected-servo trim direction to plus fifteen degrees
    [single_live.hpp, single_live_tests.cpp, single_wide_tests.cpp]
2026-10-17 Allow requested 189-degree command in connected-servo profile
2026-10-17 Enable opt-in seven-servo live control with independent outputs
2026-10-17 Calibrate floor automatically from stable classified AR planes
2026-10-17 Chalk context features, local evaluation mode, open-side finder, diagrams
    Chalk track:
    - chalk/feel_context: Find, ObjectHistory, VenueEntry and Venue features with
    SQL resolvers over a PostgreSQLSource named feel_finds, the latest-find and
    spoken-sentence resolvers, Venue.pack built by the same feel_chalk.venue_pack
    code as the local tool, and named queries last_seen and venue_pack; chalk.yaml
    at the project root. Import-checked against chalkpy 2.163.1.
    - chalk/sql/schema.sql and seed.sql: the Postgres behind the Supabase project
    (confirmed_finds, venues, venue_entries, Harvard Yard rows, demo finds).
    - feel_chalk/context.py: standard-library token exchange and /v1/query client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
2026-10-17 Room memory: a printed tag answers Where-is from earlier visits, on the phone and through Chalk
    Phone (ios/Lantern, ios/Shared/FeelCore):
    - FeelCore RoomFrame (the ARKit image-anchor frame: world <-> tag, rigid and
    right-handed only), TagSighting, RoomAnchor, RememberedTarget (per-axis median
    of a label's last 20 sightings, the same rule as Chalk) and RoomMemoryStore
    (JSON per tag id under Application Support, atomic writes, newest 200 kept).
    - ARPerception registers ios/Lantern/Resources/feel-tag-01.png as an
    ARReferenceImage 0.20 m wide and publishes onTag sightings (at most twice a
    second per tag) from the tracked image anchor.
    - RoomMemory service: anchors load when a tag is se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
2026-10-18 Add room structure maps to FeelCore: export the floor grid into the tag frame, import it as a prior, merge visits by vote
    RoomMap (RoomMap.swift) encodes a session's floor grid in the printed tag's levelled frame (cell size, lattice origin, width, height, run-length cells); FloorGrid.setPrior places a map back into the current world, where live classifications always override it; RoomMap.merge votes per cell (blocked in at least half of the visits that saw it, ties blocked); RoomFrame.levelled makes a tilted tag upright; RoomMemoryStore keeps the newest ten visits per tag. protocol/room-map-v1.json is the vector shared with chalk/feel_chalk/room_map.py.
    Verified: swift test in ios/Shared/Fe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
2026-10-18 Keep each visit's floor grid per tag on the phone and seed the planner with the merged visits when the tag is seen again
    ARPerception exports the grid into the frame of the tag last recognized just before the grid is cleared (stop, tracking reset, restart) and publishes it through onRoomMap; RoomMemory.keepStructure stores it as one visit when the camera classified at least 20 cells. On the first sighting of a tag in a world, LanternModel.sawTag hands RoomMap.merge of the stored visits to ARPerception.seedFloorGrid (same queue discipline as setRouteGoal, bound to the world epoch), so a route can be planned before the camera has seen the room; floor calibration now clears observations but kee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
2026-10-18 Document room structure memory: feel_context README section, roadmap row, release status, figure [skip ci]
    docs/diagrams/room-structure.svg is drawn by the new room_structure figure in make_diagrams.py (python3 docs/diagrams/make_diagrams.py regenerates every figure; the others are unchanged). The release status line records the software checks and that the device test is pending.
2026-10-18 test(core): add isolated depth projection encoder and packet checks
2026-10-18 Add the journey loop to FeelCore: Journey in the tag frame, a recorder for the per-frame tick, progress points every 6 m and a waypoint follower
    protocol/journey-v1.json is the vector shared with Chalk; the recorder reproduces its first journey and the split reproduces its progress points.
2026-10-18 test(core): cover basic recording mount and target edge cases
2026-10-18 describe_ahead names what is in front; wordmark removed; V sign easier to make
    "What is in front of me" now takes one photo through the gateway with a
    describe prompt and speaks one sentence, nearest things first; without
    Chalk setup it falls back to the LiDAR ranges. The FEEL wordmark leaves
    the camera header. The V sign accepts a hand up to 0.9 m away with a
    slightly looser finger pose and fires after 0.4 s of two detections.
2026-10-18 V sign with folded fingers out of frame; Chalk gateway seeded from the build config
    A hand close to the lens often loses its ring and little fingers at the frame
    edge; they now count as folded, while both extended fingers must still be
    seen. The build config carries the restricted Chalk gateway key, environment
    and model like the voice token, saved to the Keychain on first launch, so
    Where-is and describe_ahead work without typing.
2026-10-18 V sign without the wrist in frame; camera description kept in status and retried
    A hand close to the lens loses its wrist at the frame edge: the sign is now
    judged from the finger joints alone, with the knuckle spacing as the scale,
    and the range estimate falls back to it too. The describe_ahead answer is
    kept as get_status.description and announced with retries, since the
    assistant is usually still speaking when the gateway replies.
2026-10-18 What's ahead always takes a photo; no spoken obstacle notices; faster descriptions
    describe_ahead no longer carries or falls back to LiDAR ranges, and the
    assistant is told to always call it for "what is in front" questions. The
    proactive "an obstacle was ... ahead" notice is off by default (the pins
    show obstacles already); tests keep covering that path with the flag on.
    Descriptions use low reasoning effort (about 2.7 s through the gateway)
    and are re-announced every half second until the assistant is free.
2026-10-18 test: add replay pin command diagnostics
2026-10-18 fake situation
    [lib.scad, params.scad, puck.scad]
2026-10-18 pin_test.py: raise chosen pins on the real puck and read back what the firmware holds
    A bench tool for the question "does this pin open when I ask for it":
    --pins 3:2 5:4 exactly these wire slots at these bands
    --each [--band N] every slot alone, one after another
    --lidar -30:1.2 20:0.6 obstacles at bearing:range; they run through the
    production depth projector and encoder (new `lidar`
    op in feel-replay), so the pins are what the phone
    would raise for that scene
    Sends the packets over BLE to the live firmware at 10 Hz, decodes the
    status characteristic and compares the held bands with the request;
    --ser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
2026-10-18 Validate six-column replay and integrate per-pin diagnostics
2026-10-18 Rewrite README around the pitch, hardware spec and parts cost
    Six-column hardware table, sensing-to-pin mapping, link and safety
    behaviour, an itemised parts estimate (about $94 without the iPhone),
    where Chalk is used, and what has and has not been verified.
2026-10-18 Add README limitations: locally sourced parts, large cam rods, one pin per column
    Explains how the weekend's in-person parts shaped the mechanism and what
    we would change with more time: smaller rods, per-pin actuators,
    measurement and testing with blind users.
2026-10-18 Tap steady obstacle pins once a second so they stay felt
    A raised pin is felt when it moves and fades within seconds when it stays
    (steady pressure rides on slowly adapting afferents whose firing and felt
    intensity decay exponentially). FeelCore TapRhythm, applied to the final
    packet of every 100 ms tick before the adaptive highlight gate: an obstacle
    pin whose band has not changed for 1 s drops to its gap for one packet every
    1.0 s, all steady pins together. Target columns keep their own, faster taps,
    the firmware's 13° highlight dip every 600 ms for one column and the
    encoder's one-in-six drop for a span, and arrows keep their 100 ms frames,
    so what points at something beats faster than w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
2026-10-18 Restore a one-packet pin drop the phone never ended
    The phone drops a steady pin to its gap for exactly one packet (presence
    tap, span tap). If the raise packet is lost, or a BLE blackout begins on
    that frame, the controller held the pin down until the 500 ms watchdog.
    Now an accepted packet that lowers a raised column to 0 is remembered
    and, if no further packet is accepted within kHeldDropMs (150 ms), the
    previous band is commanded again. A later packet always wins, a packet
    that keeps 0 is a real disappearance, the watchdog is not refreshed and
    bench commands are unchanged. packet-loss-failsafe passes without its
    known issue; its baseline is regenerated. Host-tested only, not flashed.
    Co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
    [controller.cpp, controller.hpp, controller_tests.cpp, single_live_tests.cpp]
2026-10-18 Keep safety-neutral commands latched and strengthen replay regression coverage
    [controller.cpp, controller.hpp, controller_tests.cpp]
2026-10-18 Move documentation into docs/, add the Chalk journey figure, restyle the diagrams
    All root-level documents except README, AGENTS and CLAUDE now live in docs/
    (handoffs, event brief, CAD spec, battery notes, planning, TODO) with every
    link and mention updated. The README's Chalk section opens with the
    hand-drawn journey figure, embedded unchanged. The generated diagrams take
    the same chalkboard theme: dark board, chalk text, blue phone flows, yellow
    hatched Chalk cards; the system figure also says six columns and sectors.
2026-10-18 Add the puck assembly clip to the README hardware section
    A ten-second GIF of the 3D viewer exploding the assembly plays inline;
    the full 24 s clip is a 1280-wide H.264 MP4 under docs/media.
2026-10-18 Center the puck assembly GIF in the README
2026-10-18 Verify pin test hold evidence and always attempt neutral cleanup
2026-10-18 Document current validation and ESP32 programming handoff
2026-10-18 Record successful ESP32 build in canonical main checkout
2026-10-20 preview + battery corrections
